OpenSourceSDRLab/XC7Z100-ADRV9371/hardware/XC7Z100-ADRV9371_Schematic.pdf

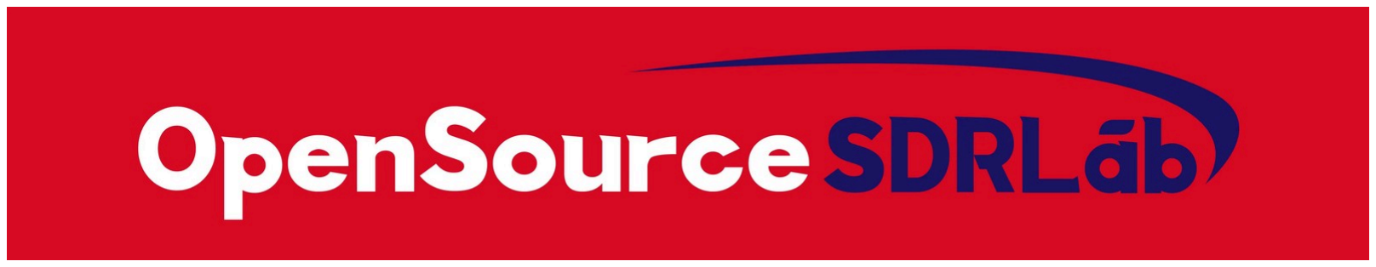
[picture p9: figure]

## © 2026 OpenSourceSDRLab. All rights reserved. · www.opensourcesdrlab.com

# OPENSOURCESDRLAB DOCUMENTATION

# XC7Z100-ADRV9371 Schematic

Product | XC7Z100-ADRV9371
Document | OSSDRLAB-XC7Z100-ADRV9371-SCH
Version | 1.0
Date | 2026-11-12

This document contains the circuit schematic (revision V1.0) of the OpenSourceSDRLab XC7Z100-ADRV9371 board, exported from Altium Designer (A2/A3/A4 sheets). The twenty schematic sheets follow this cover page.

OpenSourceSDRLab | XC7Z100-ADRV9371 Schematic

## © 2026 OpenSourceSDRLab. All rights reserved. · www.opensourcesdrlab.com

Sheet | Content
1 | Power supply: 12 V DC input and fuse, MP8774 / MP2145 buck regulators (5 V, 3.3 V, 1.8 V, 1.35 V, 1.0 V), MGT supplies, LP5907 LDO, power-good signals
2 | Zynq PS core: PS clock and reset, configuration and JTAG, boot-mode switch, MIO assignments (QSPI, SD card, USB ULPI, Ethernet RGMII, UART0), status LEDs
3 | Zynq HR I/O banks (banks 9–13): ADRV9371 control and GPIO, GPS, extension LVDS pairs
4 | Zynq HP I/O banks (banks 33–35): PL DDR3 interface and system clock
5 | Zynq GTX transceiver bank 112: JESD204B SERDES lanes and reference clocks
6 | Zynq PS DDR bank: PS DDR3 interface
7 | Zynq power pins and decoupling
8 | PS DDR3 memory (MT41K256M16, 1 GB)
9 | PL DDR3 memory (MT41K256M16, 1 GB)
10 | Two W25Q256 QSPI flash devices, microSD card slot
11 | USB 2.0: USB3320 ULPI PHY and USB Type-C connector
12 | Gigabit Ethernet: RTL8211F RGMII PHY and RJ45 jack
13 | Debug port: FT2232H USB-JTAG and USB-UART bridge on the DEBUG Type-C connector
14 | RF receive inputs: RX1, RX2, ORX1, ORX2 baluns and connectors
15 | AD9371 RF pins, TX1 and TX2 baluns, external TX/RX LO inputs
16 | Clocking: AD9528 clock generator, 122.88 MHz VCXO, reference clock input, status LEDs, SPI level translation
17 | AD9371 GPIO, SPI control and JESD204B SERDES interface
18 | AD9371 power pins and decoupling
19 | AD9371 power module: ADP5054 quad regulator (1.3 V analog, 1.3 V digital, 1.8 V, 3.3 V), filtering, enables, clock supply
20 | Other interfaces: M24C02 EEPROM, MAX-M10S GPS module with MMCX antenna input, 60-pin extension connector (24 LVDS pairs)

Product page: https://opensourcesdrlab.com/products/opensourcesdrlab-high-performance-ad9371-board-for-fpga-sdr-with-silver-shell-1 (https://opensourcesdrlab.com/products/opensourcesdrlab-high-performance-ad9371-board-for-fpga-sdr-with-silver-shell-1)

# Questions about the hardware: support@opensourcesdrlab.com

# VIN_2 13 GND

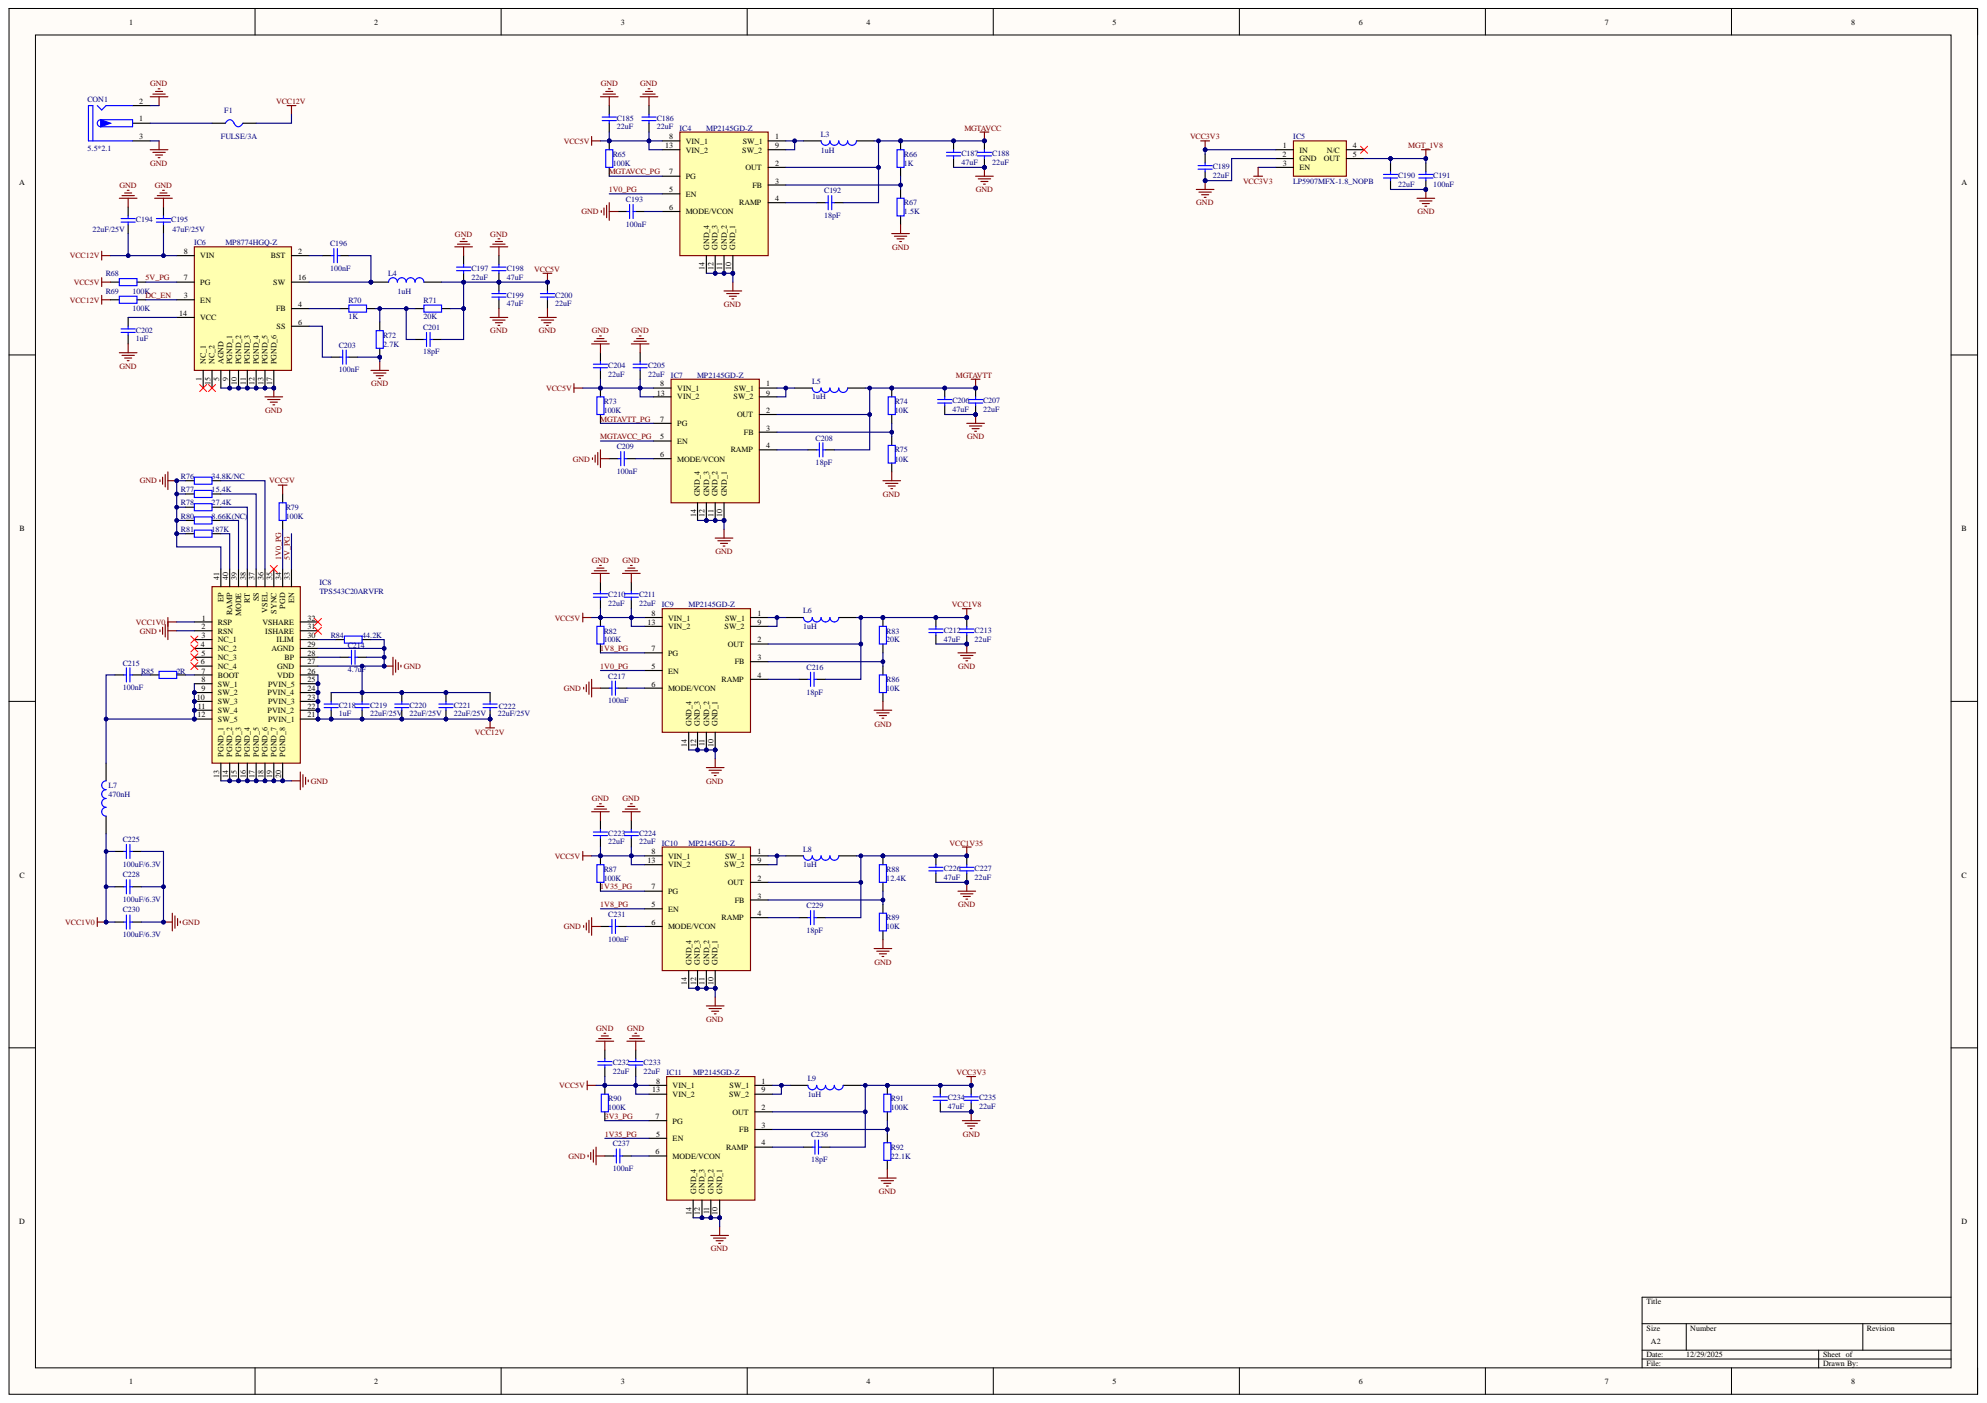
[picture p10: page 3]

# XC7Z100-2FFG900I U

4 PS_MIO0_500 | D23 PS_MIO1_500 | F23 PS_MIO2_500 | C23 PS_MIO3_500 | E23 PS_MIO4_500 | C24 PS_MIO5_500 | D24 PS_MIO6_500 | B24 PS_MIO7_500 | C21 PS_MIO8_500 | A24 PS_MIO9_500 | E22 PS_MIO10_500 | A23 PS_MIO11_500 | E21 PS_MIO12_500 | F22 PS_MIO13_500 | B22 PS_MIO14_500 | C22 PS_MIO15_500 | L19 PS_MIO16_501 | K21 PS_MIO17_501 | K20 PS_MIO18_501 | J20 PS_MIO19_501 | M20 PS_MIO20_501 | J19 PS_MIO21_501 | L20 PS_MIO22_501 | J21 PS_MIO23_501 | M19 PS_MIO24_501 | G19 PS_MIO25_501 | M17 PS_MIO26_501 | G20 PS_MIO27_501 | L17 PS_MIO28_501 | H22 PS_MIO29_501 | L18 PS_MIO30_501 | H21 PS_MIO31_501 | K17 PS_MIO32_501 | G22 PS_MIO33_501 | K18 PS_MIO34_501 | G21 PS_MIO35_501 | H17 PS_MIO36_501 | B21 PS_MIO37_501 | A20 PS_MIO38_501 | F18 PS_MIO39_501 | B20 PS_MIO40_501 | J18 PS_MIO41_501 | D20 PS_MIO42_501 | E18 PS_MIO43_501 | E20 PS_MIO44_501 | H18 PS_MIO45_501 | F20 PS_MIO46_501 | A18 PS_MIO47_501 | C19 PS_MIO48_501 | D18 PS_MIO49_501 | A19 PS_MIO50_501 | F19 PS_MIO51_501 | D19 PS_MIO52_501 | C18 PS_MIO53_501

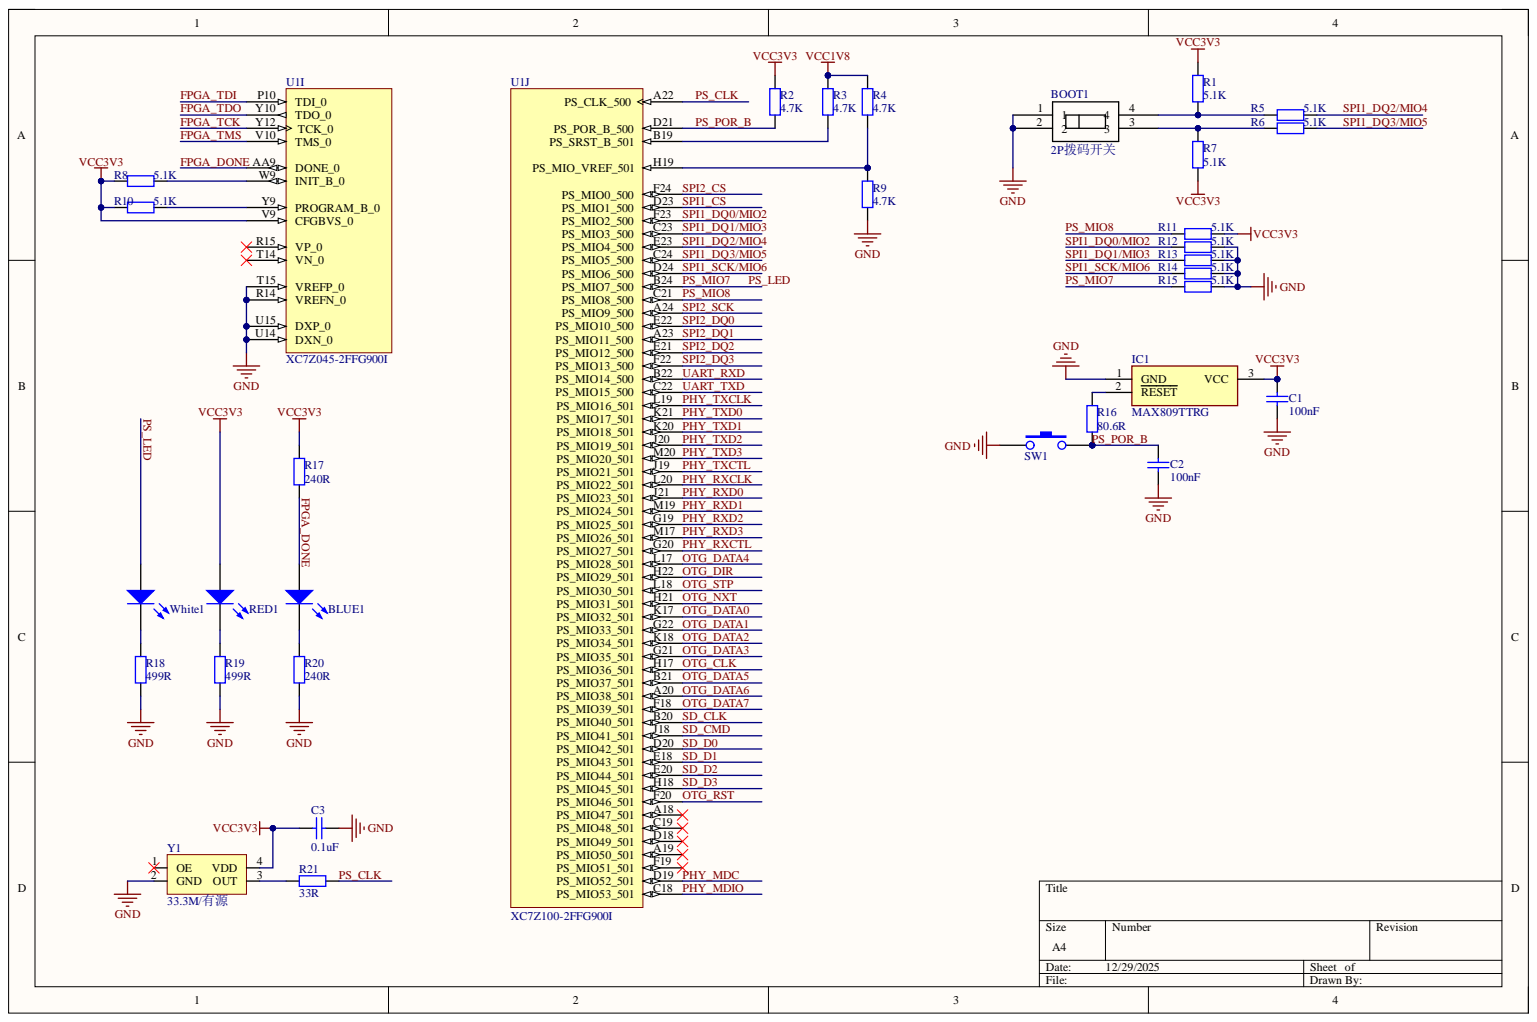
[picture p11: page 4]

1 IO_0_13 | P30 IO_L1P_T0_13 | R30 IO_L1N_T0_13 | T30 IO_L2P_T0_13 | U30 IO_L2N_T0_13 | N28 IO_L3P_T0_DQS_13 | P28 IO_L3N_T0_DQS_13 | N29 IO_L4P_T0_13 | P29 IO_L4N_T0_13 | T29 IO_L5P_T0_13 | U29 IO_L5N_T0_13 | R28 IO_L6P_T0_13 | T28 IO_L6N_T0_VREF_13 | V28 IO_L7P_T1_13 | V29 IO_L7N_T1_13 | W29 IO_L8P_T1_13 | W30 IO_L8N_T1_13 | V27 IO_L9P_T1_DQS_13 | W28 IO_L9N_T1_DQS_13 | W25 IO_L10P_T1_13 | W26 IO_L10N_T1_13 | U25 IO_L11P_T1_SRCC_13 | V26 IO_L11N_T1_SRCC_13 | U26 IO_L12P_T1_MRCC_13 | U27 IO_L12N_T1_MRCC_13 | R25 IO_L13P_T2_MRCC_13 | R26 IO_L13N_T2_MRCC_13 | R27 IO_L14P_T2_SRCC_13 | T27 IO_L14N_T2_SRCC_13 | N26 IO_L15P_T2_DQS_13 | N27 IO_L15N_T2_DQS_13 | P25 IO_L16P_T2_13 | P26 IO_L16N_T2_13 | T24 IO_L17P_T2_13 | T25 IO_L17N_T2_13 | P23 IO_L18P_T2_13 | P24 IO_L18N_T2_13 | P21 IO_L19P_T3_13 | R21 IO_L19N_T3_VREF_13 | T22 IO_L20P_T3_13 | T23 IO_L20N_T3_13 | R22 IO_L21P_T3_DQS_13 | R23 IO_L21N_T3_DQS_13 | U22 IO_L22P_T3_13 | V22 IO_L22N_T3_13 | U24 IO_L23P_T3_13 | V24 IO_L23N_T3_13 | V23 IO_L24P_T3_13 | W24 IO_L24N_T3_13 | V21 IO_25_13
0 IO_L1N_T0_12 | AB29 IO_L2P_T0_12 | AB30 IO_L2N_T0_12 | Y26 IO_L3P_T0_DQS_12 | Y27 IO_L3N_T0_DQS_12 | Y28 IO_L4P_T0_12 | AA29 IO_L4N_T0_12 | AA27 IO_L5P_T0_12 | AA28 IO_L5N_T0_12 | AB25 IO_L6P_T0_12 | AB26 IO_L6N_T0_VREF_12 | AC26 IO_L7P_T1_12 | AD26 IO_L7N_T1_12 | AD30 IO_L8P_T1_12 | AE30 IO_L8N_T1_12 | AC29 IO_L9P_T1_DQS_12 | AD29 IO_L9N_T1_DQS_12 | AD25 IO_L10P_T1_12 | AE26 IO_L10N_T1_12 | AB27 IO_L11P_T1_SRCC_12 | AC27 IO_L11N_T1_SRCC_12 | AC28 IO_L12P_T1_MRCC_12 | AD28 IO_L12N_T1_MRCC_12 | AE28 IO_L13P_T2_MRCC_12 | AF28 IO_L13N_T2_MRCC_12 | AE27 IO_L14P_T2_SRCC_12 | AF27 IO_L14N_T2_SRCC_12 | AF29 IO_L15P_T2_DQS_12 | AG29 IO_L15N_T2_DQS_12 | AF30 IO_L16P_T2_12 | AG30 IO_L16N_T2_12 | AG26 IO_L17P_T2_12 | AG27 IO_L17N_T2_12 | AE25 IO_L18P_T2_12 | AF25 IO_L18N_T2_12 | AH28 IO_L19P_T3_12 | AH29 IO_L19N_T3_VREF_12 | AJ30 IO_L20P_T3_12 | AK30 IO_L20N_T3_12 | AJ28 IO_L21P_T3_DQS_12 | AJ29 IO_L21N_T3_DQS_12 | AK27 IO_L22P_T3_12 | AK28 IO_L22N_T3_12 | AH26 IO_L23P_T3_12 | AH27 IO_L23N_T3_12 | AJ26 IO_L24P_T3_12 | AK26 IO_L24N_T3_12 | AA25 IO_25_12

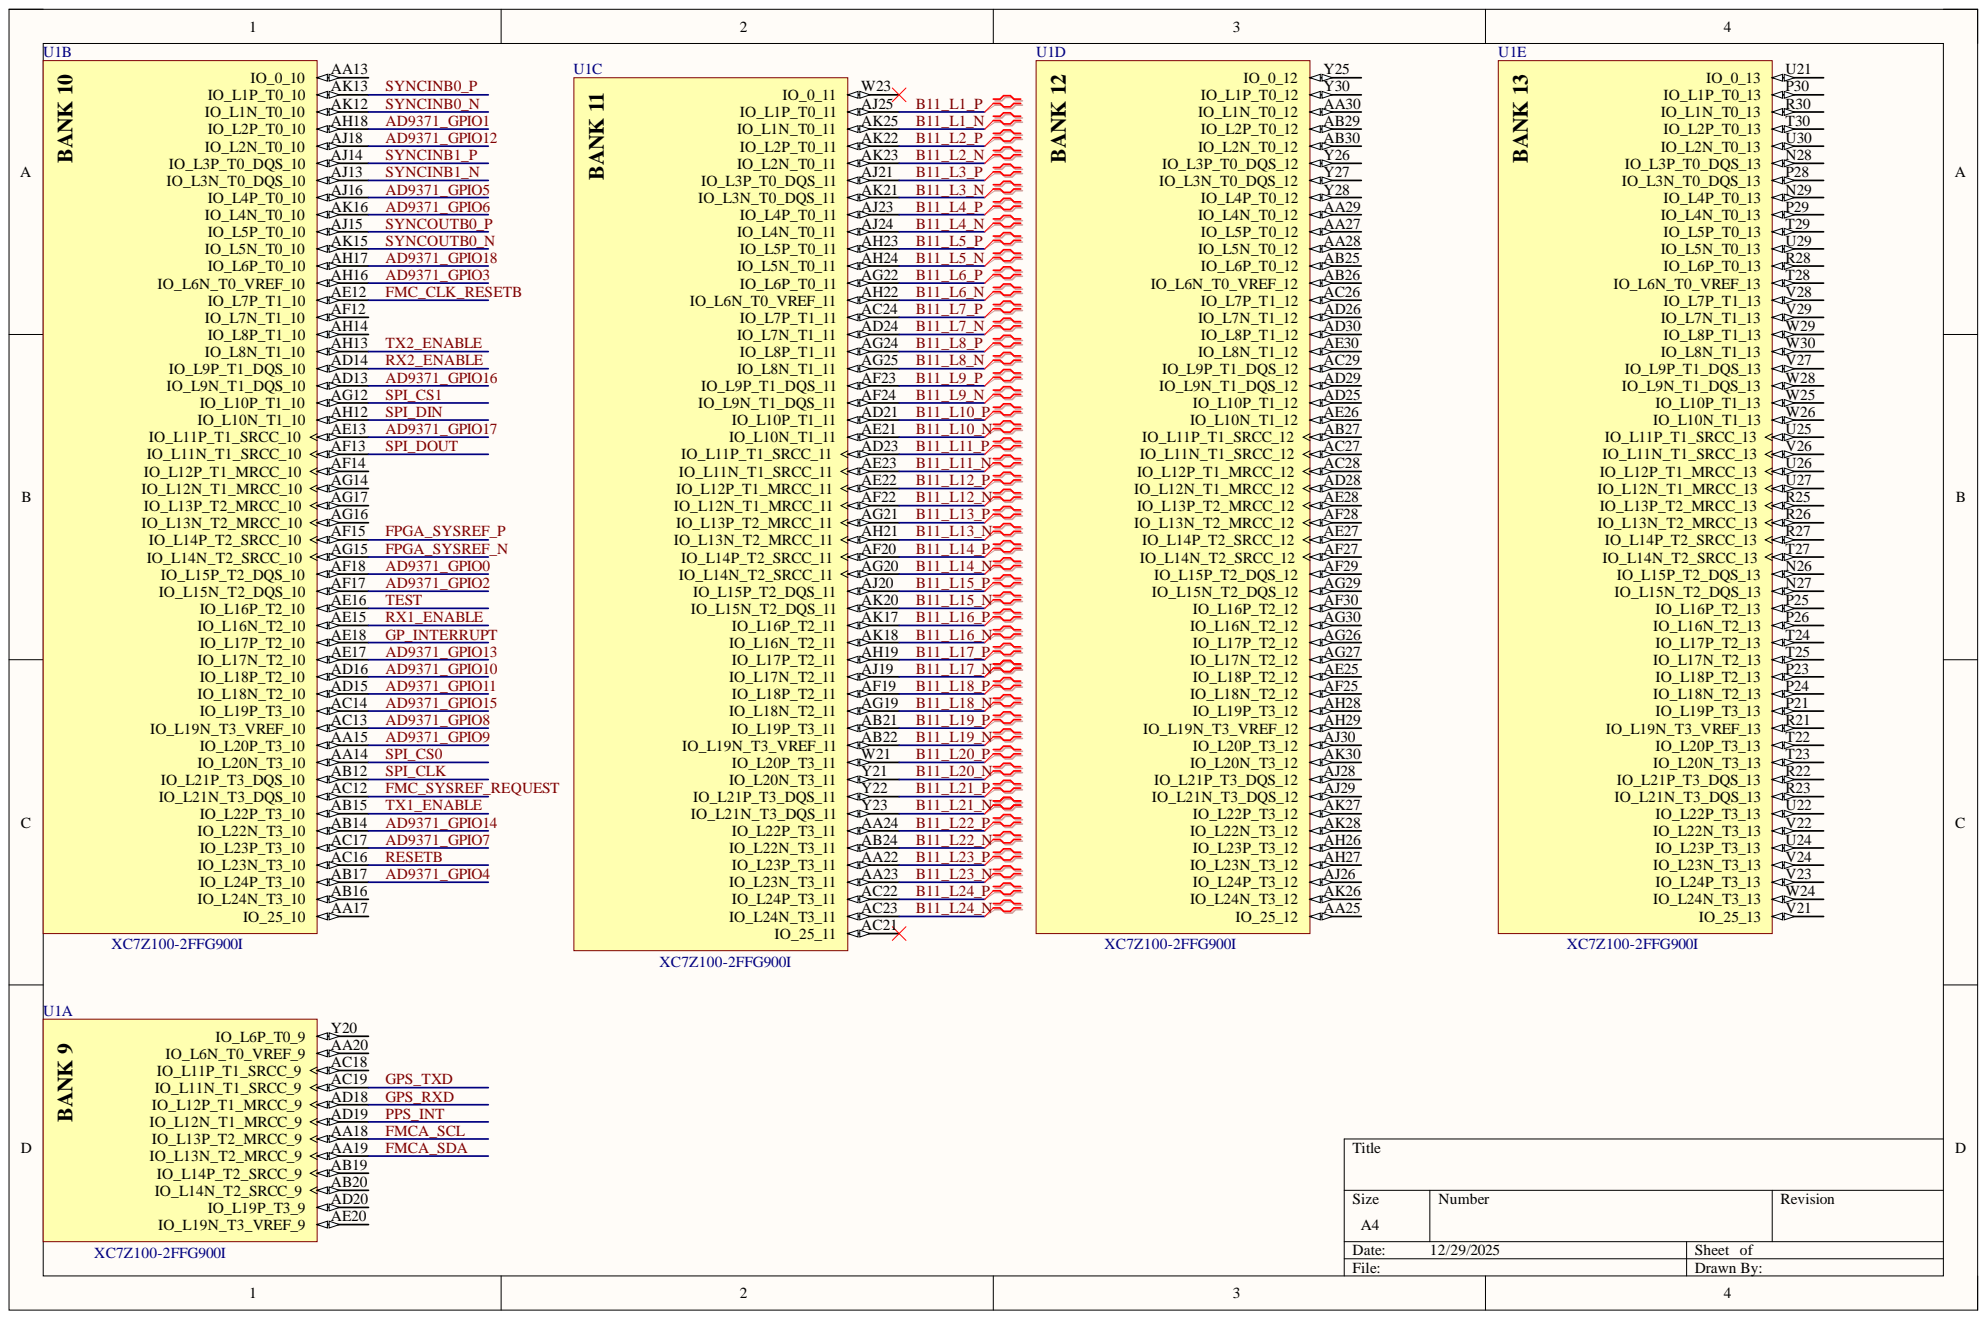
[picture p12: page 5]
SPI_CL; K FMC_SYSREF_RE; SPI_; FMC_CL; _RESE; SPI_CS1; SPI_CS0 AD9371_; RESE; ERRU; FMCA; _SCL; FPG; _SYSREF_; NCO; NCINB1; NCINB0; PPS_IN; GPS_RX; GPS_; XC7Z100-2FFG900I; 9 KNAB; 0 IO_L6N_T0_VREF_9; AC18 IO_L11P_T1_SRCC_9; AC19 IO_L11N_T1_SRCC_9; AD18 IO_L12P_T1_MRCC_9; AD19 IO_L12N_T1_MRCC_9; AA18 IO_L13P_T2_MRCC_9; AA19 IO_L13N_T2_MRCC_9; AB19 IO_L14P_T2_SRCC_9; AB20 IO_L14N_T2_SRCC_9; AE20 IO_L19N_T3_VREF_9; 31 KNAB; 21 KNAB; 11 KNAB; AJ21 IO_L3P_T0_DQS_11; AK21 IO_L3N_T0_DQS_11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

D R24 | 1K | GND R26 | 80.6R | VCC1V
6 IO_0_VRN_35 | L15 IO_L1P_T0_AD0P_35 | L14 IO_L1N_T0_AD0N_35 | J13 IO_L2P_T0_AD8P_35 | H13 IO_L2N_T0_AD8N_35 | L13 IO_L3P_T0_DQS_AD1P_35 | K13 IO_L3N_T0_DQS_AD1N_35 | J14 IO_L4P_T0_35 | H14 IO_L4N_T0_35 | K15 IO_L5P_T0_AD9P_35 | J15 IO_L5N_T0_AD9N_35 | J16 IO_L6P_T0_35 | H16 IO_L6N_T0_VREF_35 | G17 IO_L7P_T1_AD2P_35 | G16 IO_L7N_T1_AD2N_35 | G15 IO_L8P_T1_AD10P_35 | G14 IO_L8N_T1_AD10N_35 | G12 IO_L9P_T1_DQS_AD3P_35 | F12 IO_L9N_T1_DQS_AD3N_35 | F13 IO_L10P_T1_AD11P_35 | E12 IO_L10N_T1_AD11N_35 | E13 IO_L11P_T1_SRCC_35 | D13 IO_L11N_T1_SRCC_35 | F15 IO_L12P_T1_MRCC_35 | F14 IO_L12N_T1_MRCC_35 | E16 IO_L13P_T2_MRCC_35 | E15 IO_L13N_T2_MRCC_35 | D15 IO_L14P_T2_AD4P_SRCC_35 | D14 IO_L14N_T2_AD4N_SRCC_35 | F17 IO_L15P_T2_DQS_AD12P_35 | E17 IO_L15N_T2_DQS_AD12N_35 | D16 IO_L16P_T2_35 | C16 IO_L16N_T2_35 | C17 IO_L17P_T2_AD5P_35 | B16 IO_L17N_T2_AD5N_35 | B17 IO_L18P_T2_AD13P_35 | A17 IO_L18N_T2_AD13N_35 | C14 IO_L19P_T3_35 | C13 IO_L19N_T3_VREF_35 | C12 IO_L20P_T3_AD6P_35 | B12 IO_L20N_T3_AD6N_35 | B15 IO_L21P_T3_DQS_AD14P_35 | A15 IO_L21N_T3_DQS_AD14N_35 | C11 IO_L22P_T3_AD7P_35 | B11 IO_L22N_T3_AD7N_35 | B14 IO_L23P_T3_35 | A14 IO_L23N_T3_35 | A13 IO_L24P_T3_AD15P_35 | A12 IO_L24N_T3_AD15N_35 | M16 IO_25_VRP_35

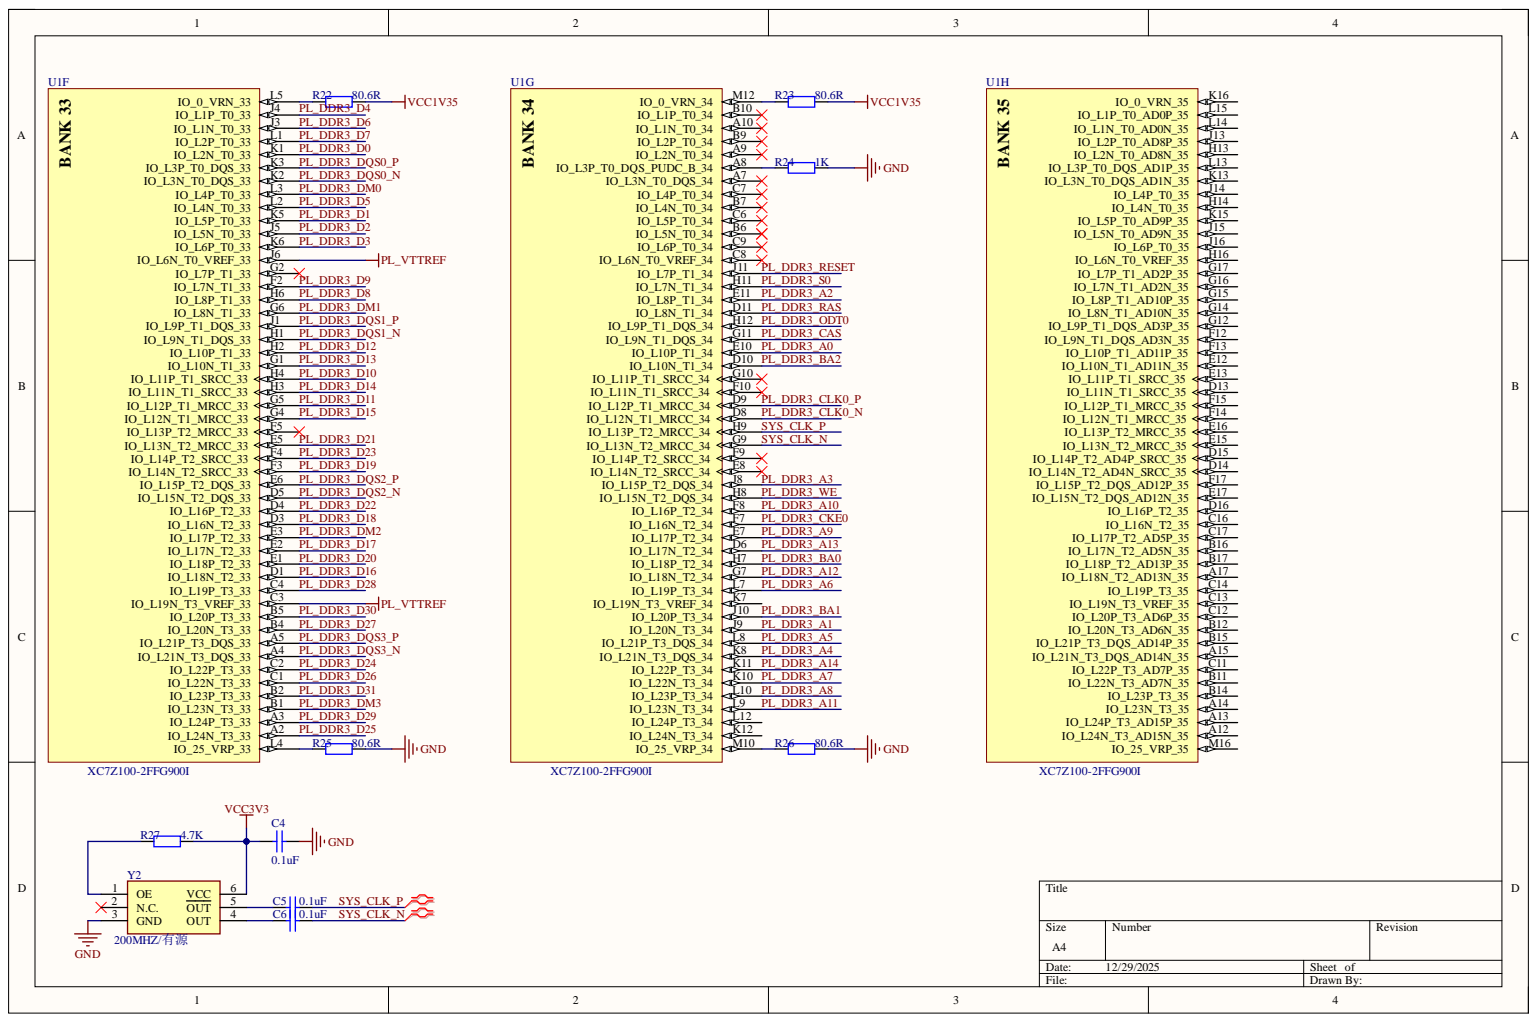
[picture p13: page 6]

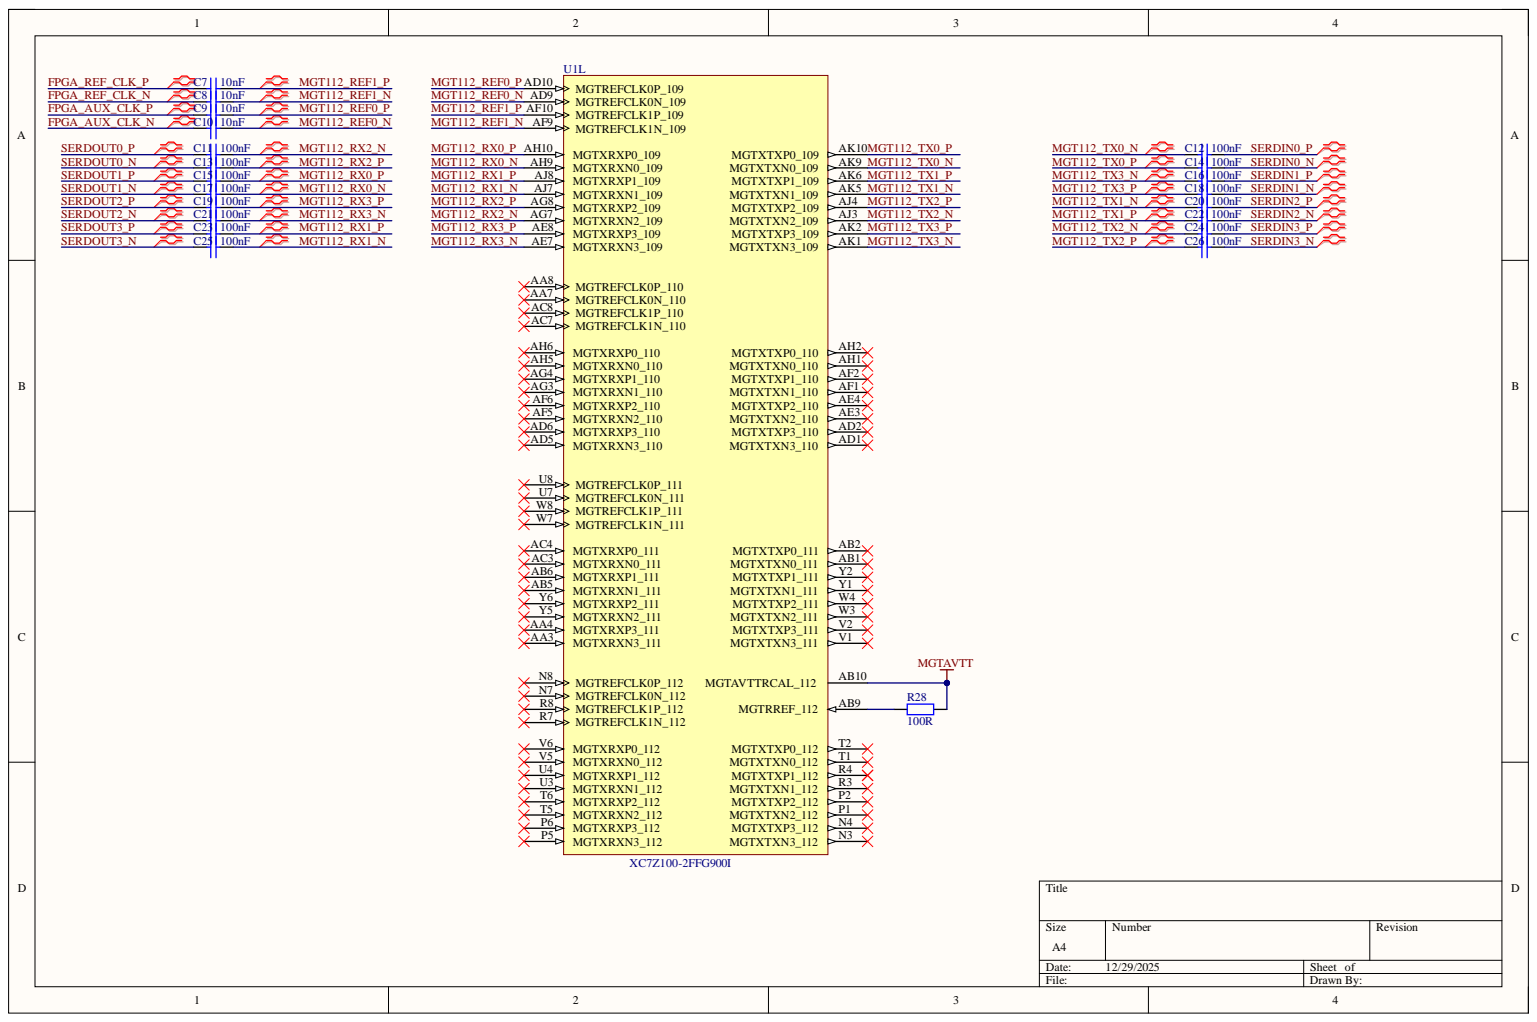
[picture p14: page 7]

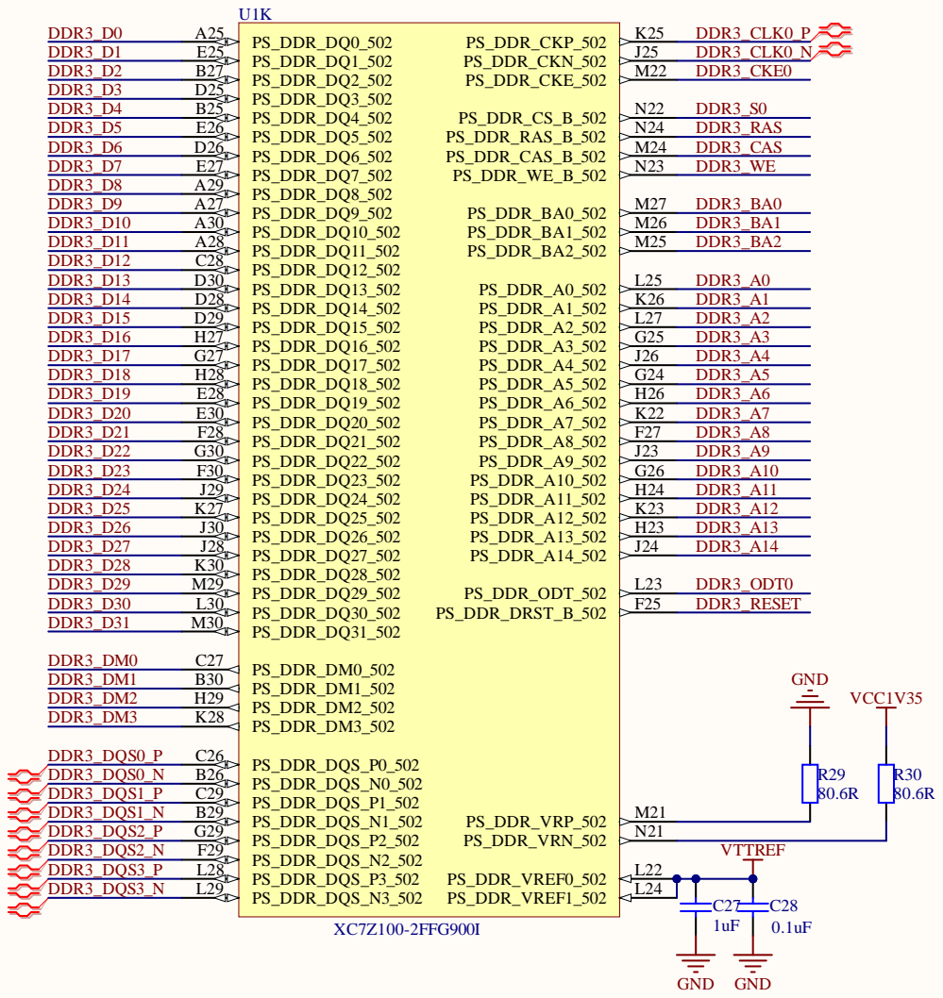
[picture p15: page 8]

M13 | VCCINT M15 | VCCINT N12 | VCCINT N14 | VCCINT P13 | VCCINT R12 | VCCINT R16 | VCCINT T13 | VCCINT U12 | VCCINT U16 | VCCINT V13 | VCCINT V15 | VCCINT W12 | VCCINT W14 | VCCINT W16 | VCCINT Y17 | VCCINT

### PIC2902 COC29

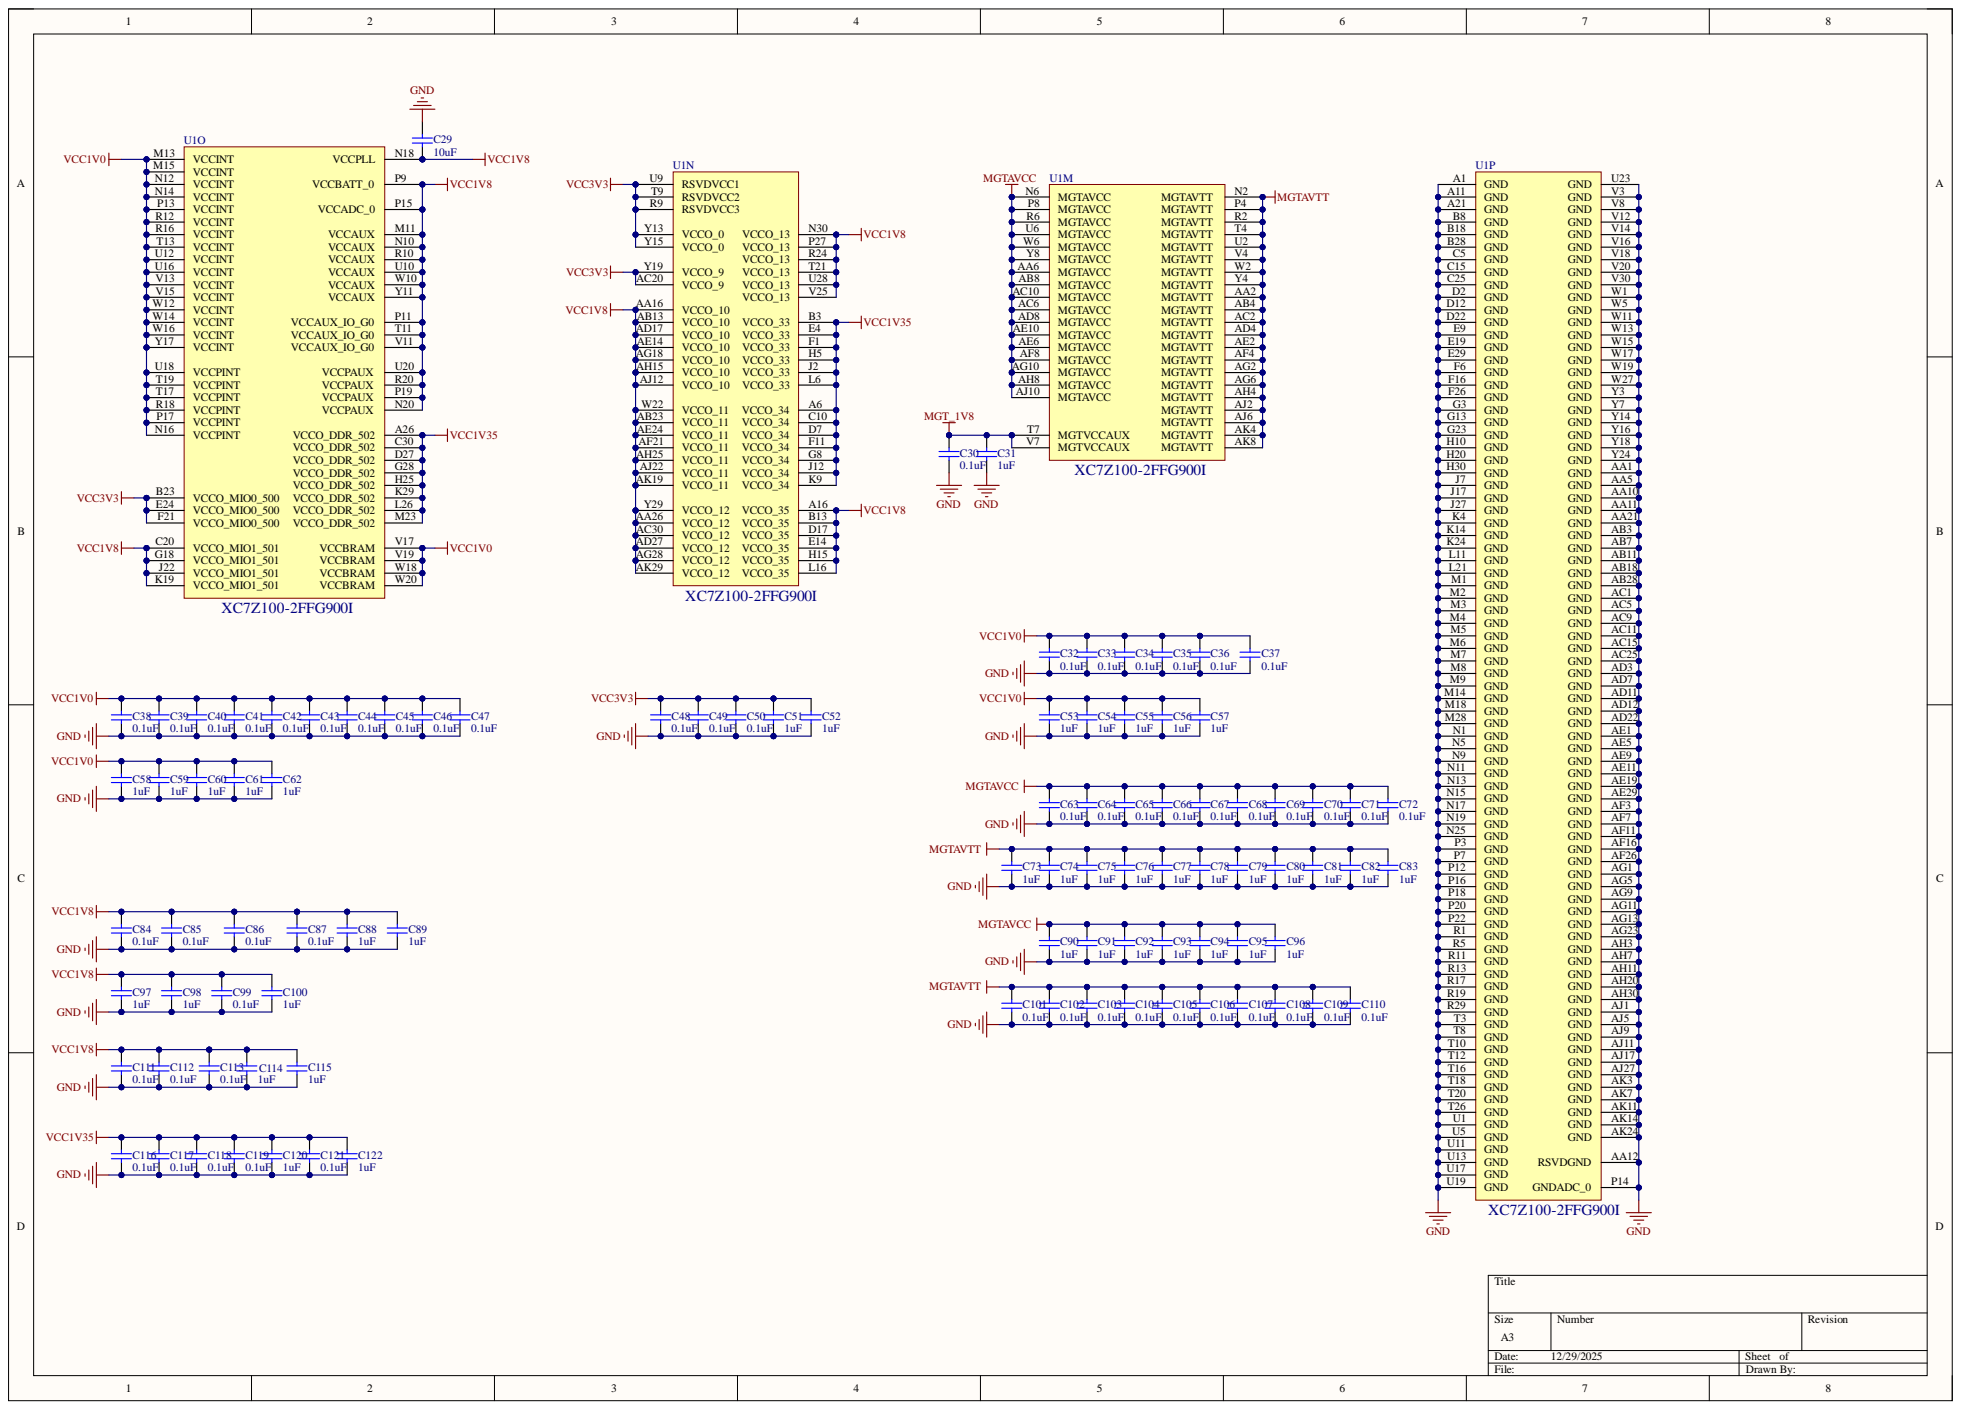
[picture p16: page 9]

PIC8602 COC86

PIC9502 COC95

5 P2 | A2 P3 | A1 P7 | A4 P8 | A7 R2 | A9 R3 | A1

# U2A MT41K256M16R

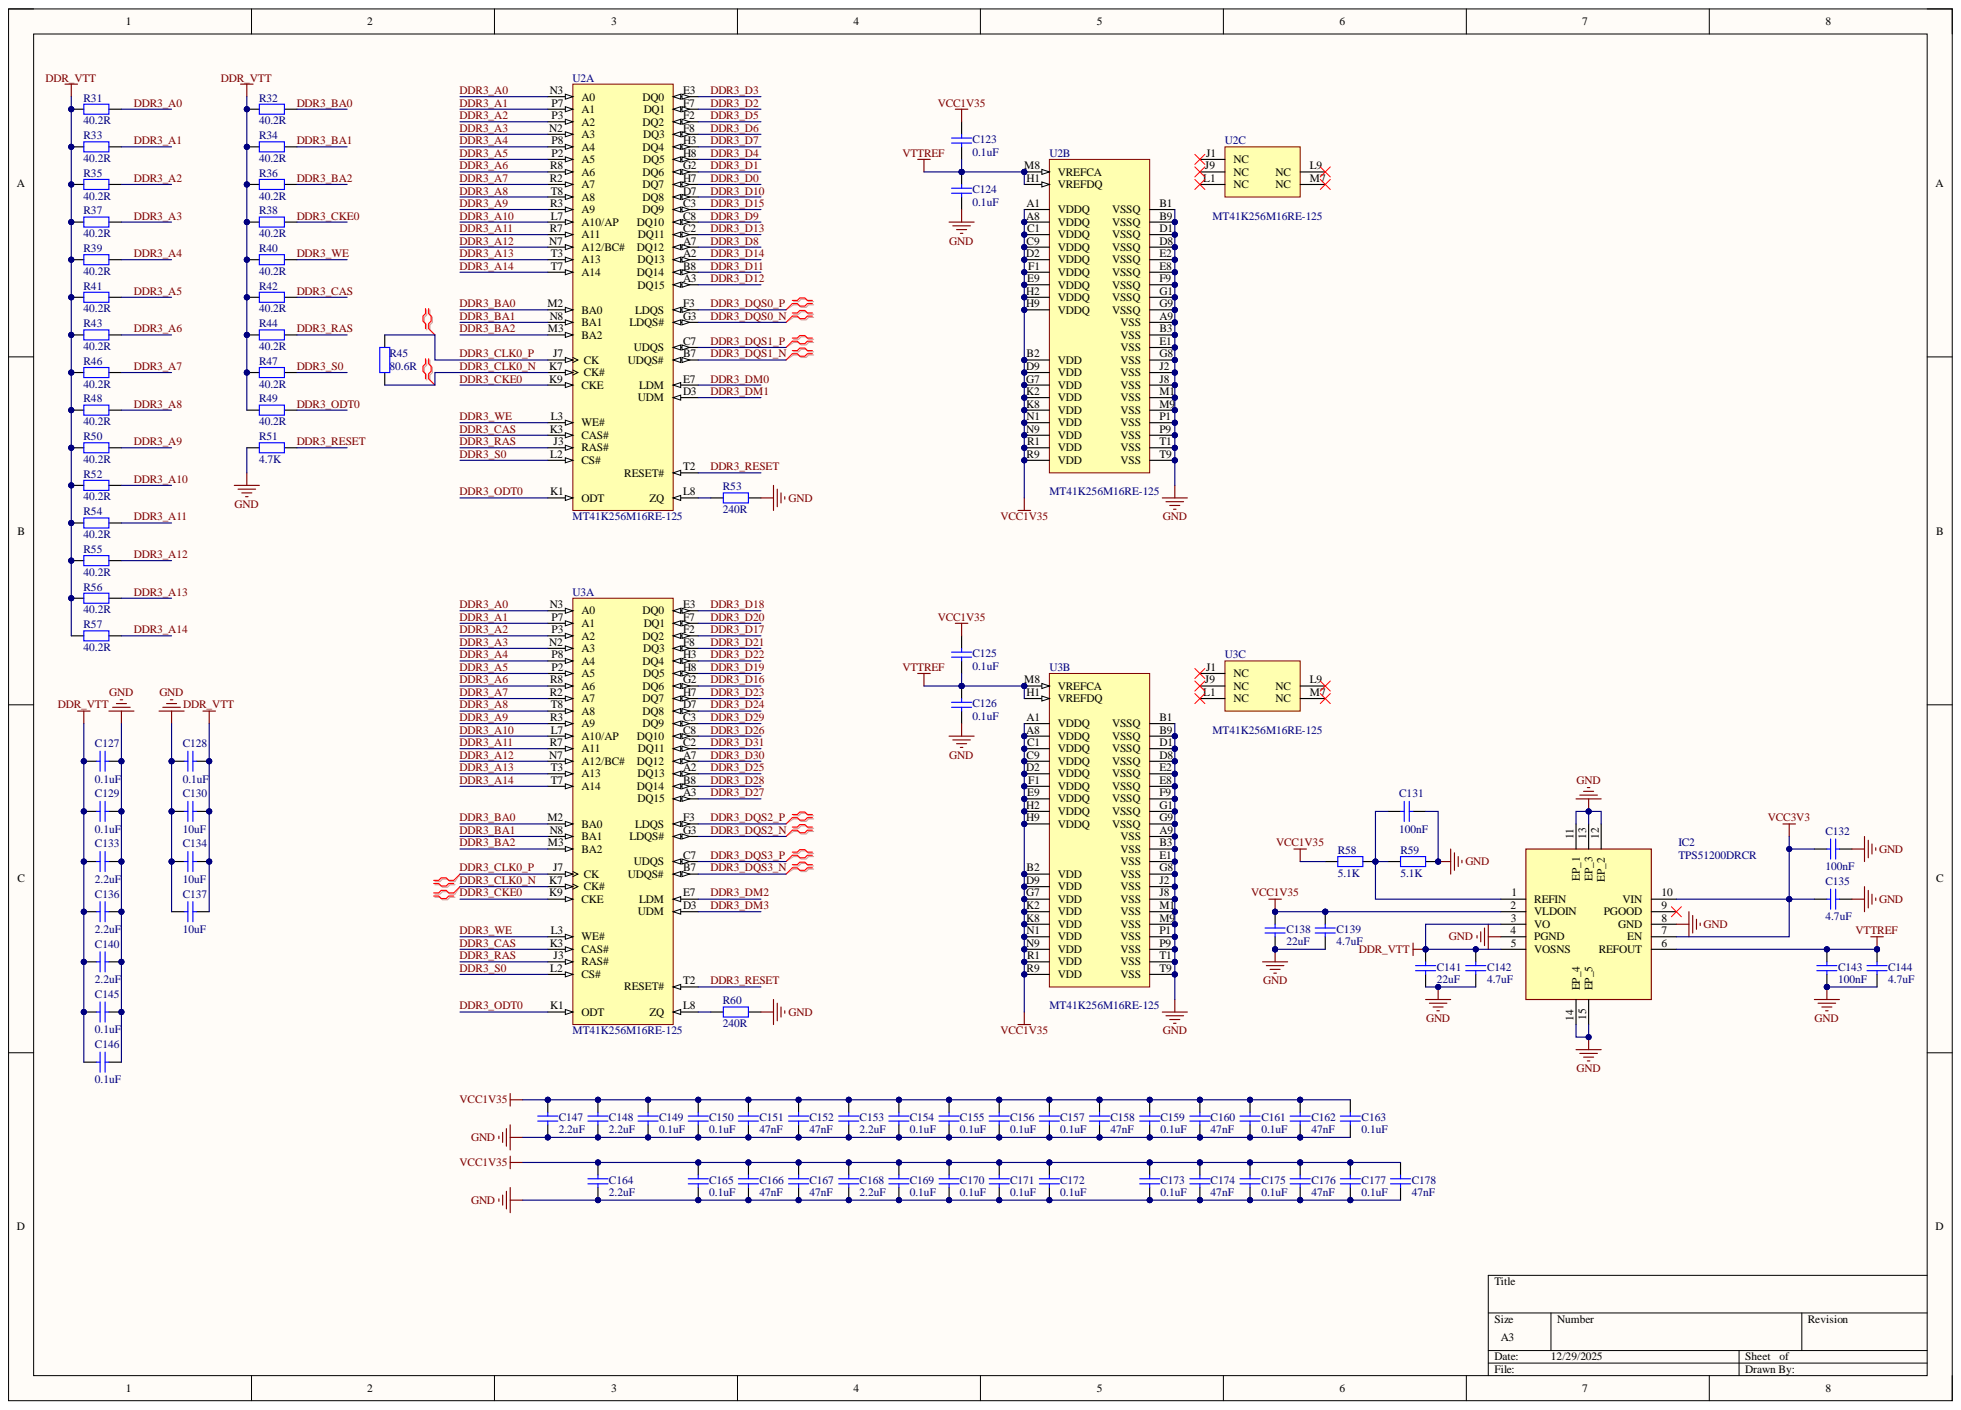
[picture p17: page 10]

5 P2 | A2 P3 | A1 P7 | A4 P8 | A7 R2 | A9 R3 | A1

# U8A MT41K256M16R

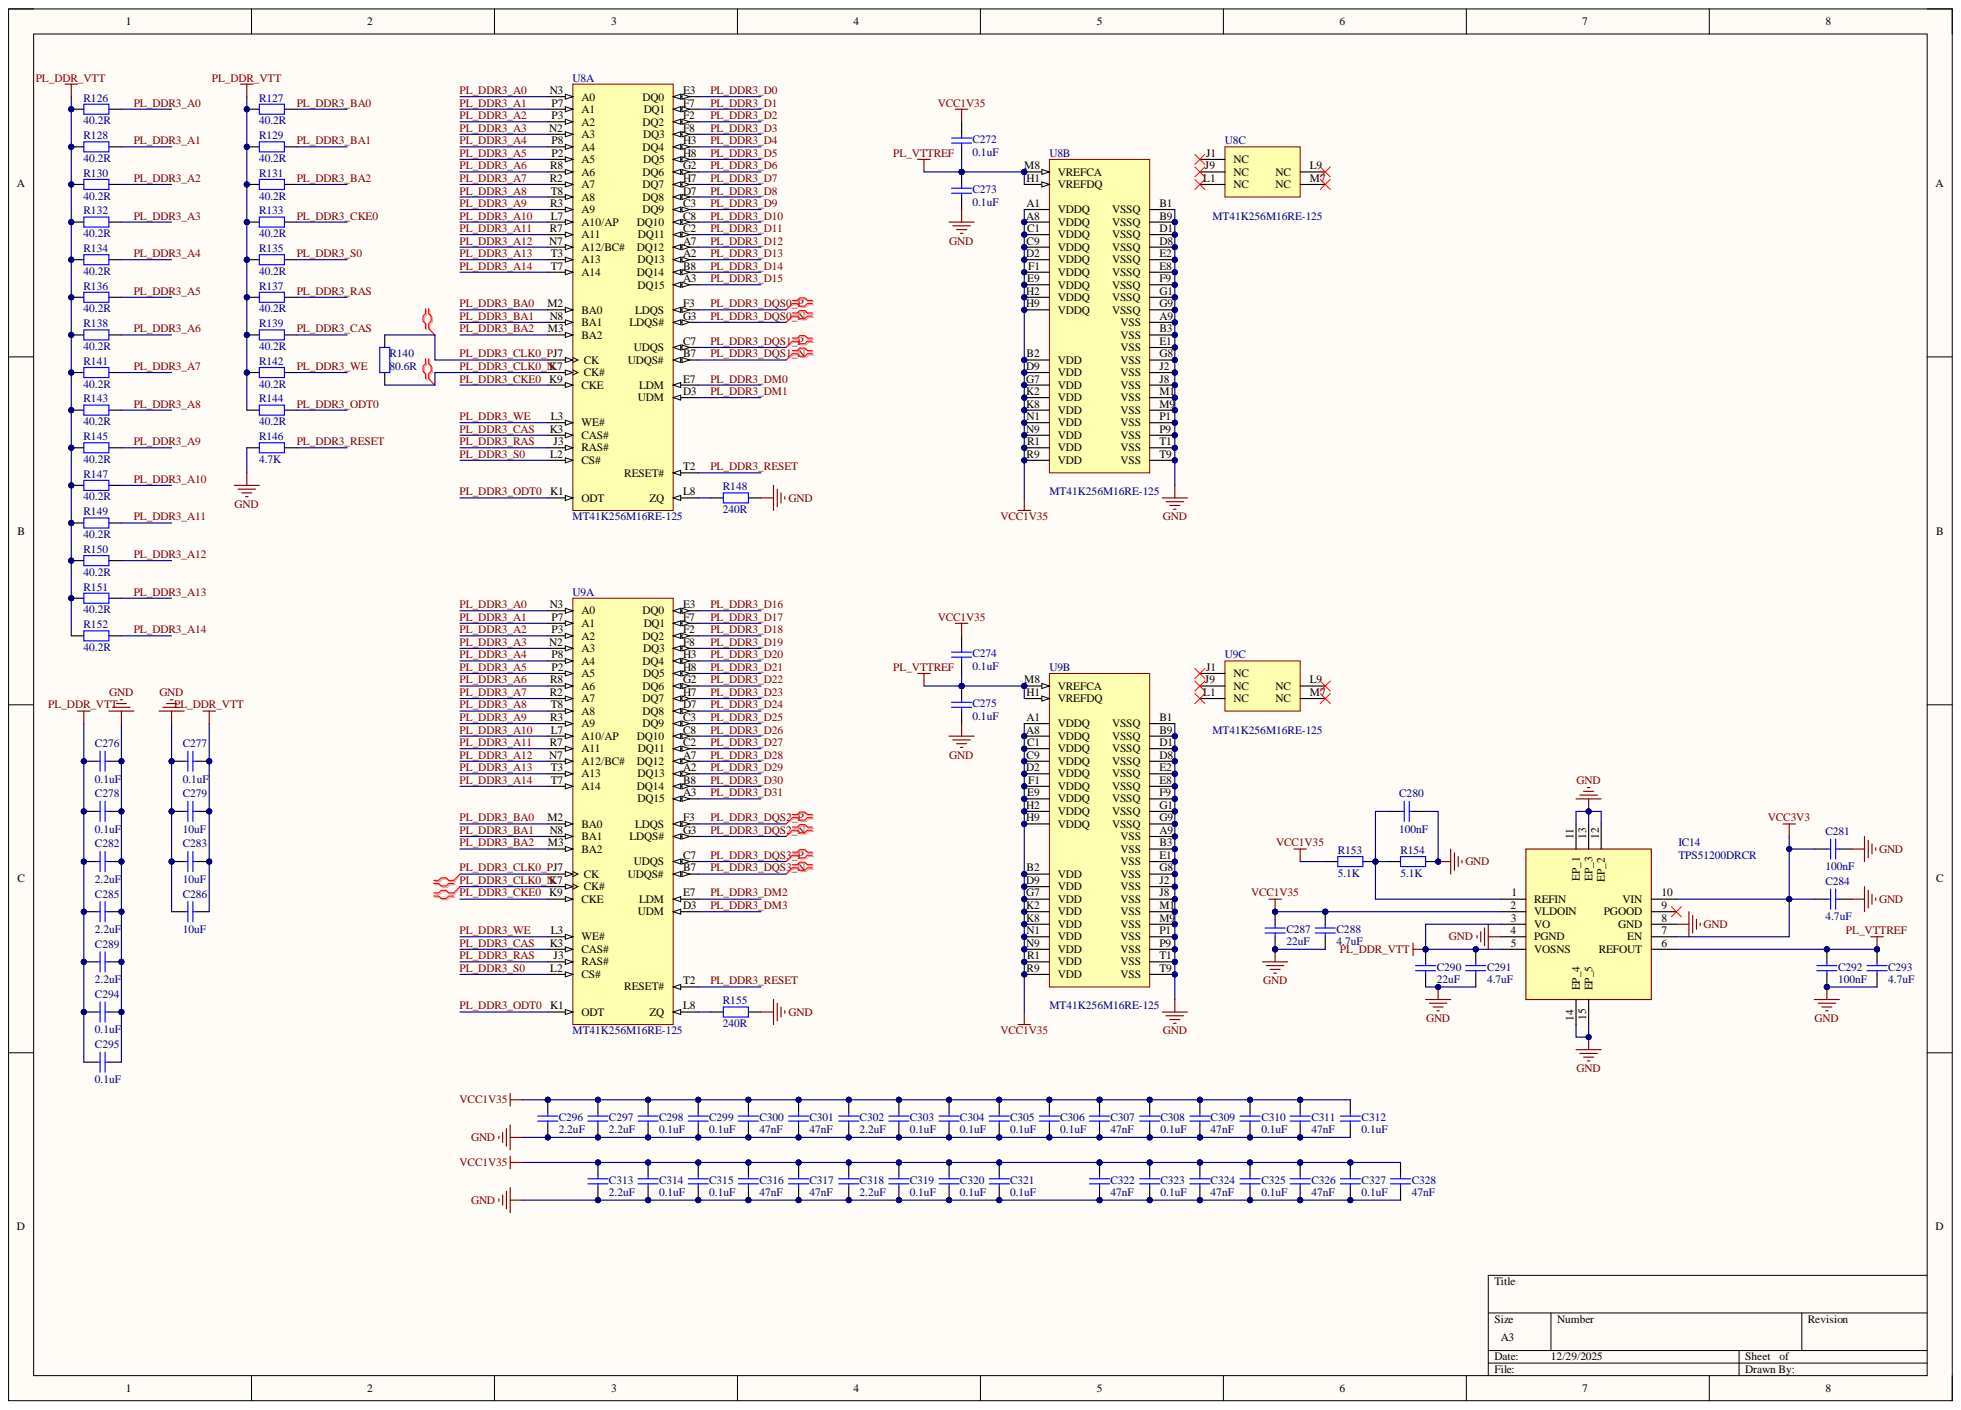
[picture p18: page 11]

# 3VCC1

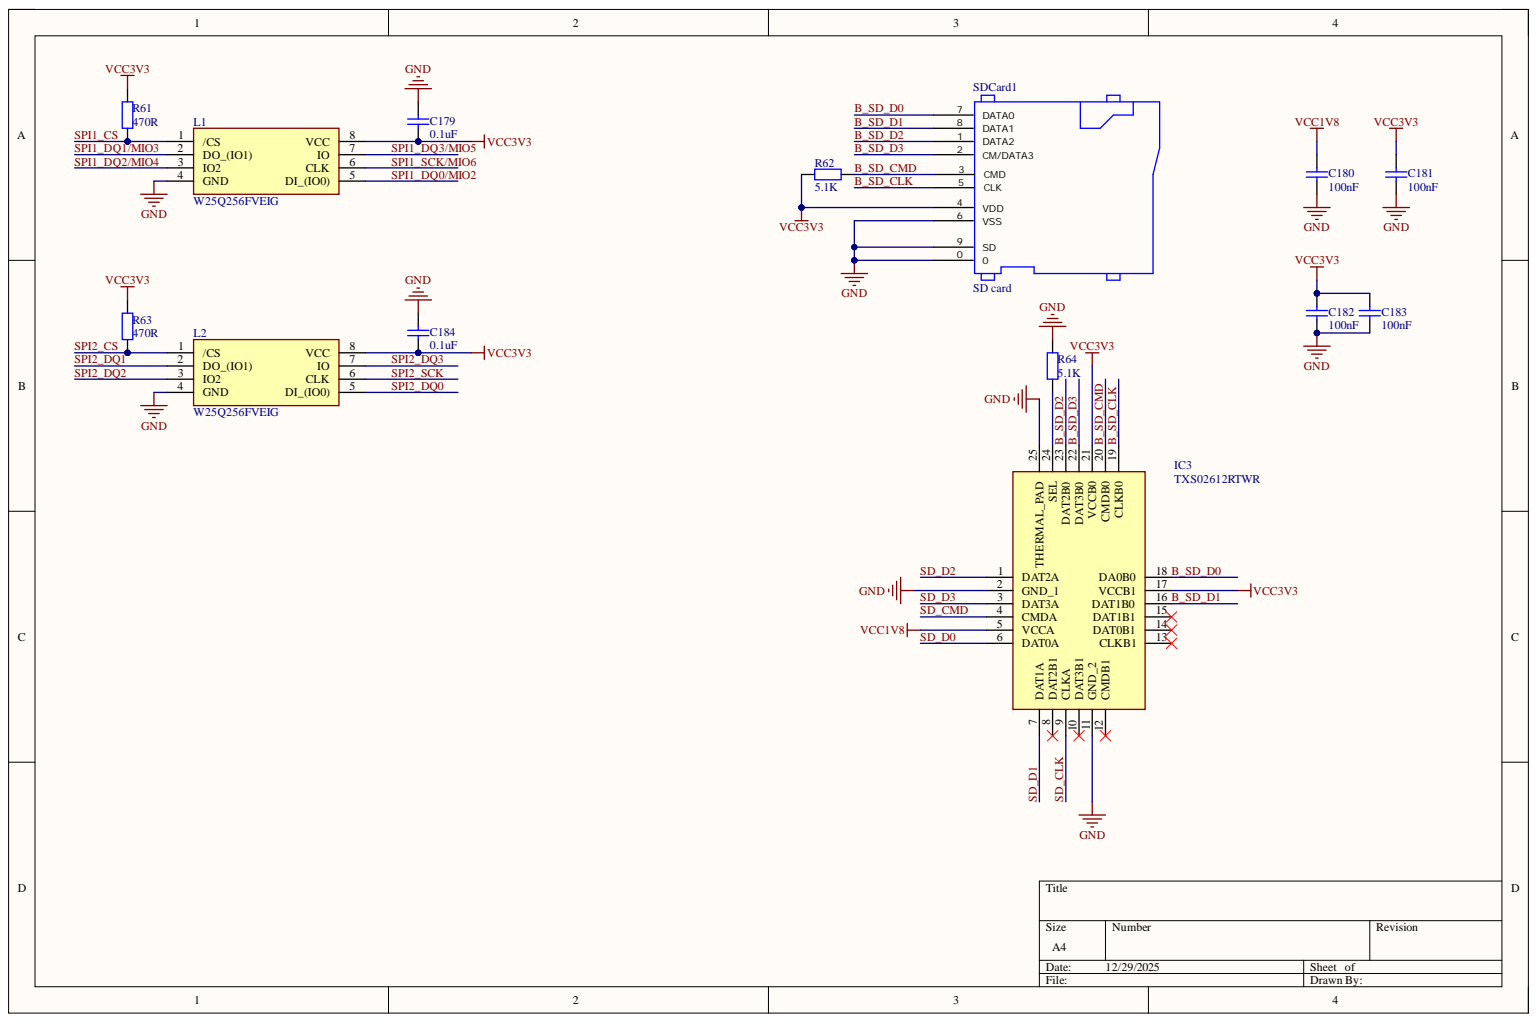
[picture p19: page 12]
Size; umb; Rev; Draw; VCC3; SPI1; _SCK/MI; SPI2; VCC; VDD; VSS; SDCard; SD card; CMD; DAT1A 7; DAT2B1 8 CLKA 9; DAT3B1 10; GND; CMDB1 12 DA; VCCB; THERMAL; PAD 25; SEL 24; DAT2B0 23; DAT3B0 22; VCCB0 21; CMDB0 20; CLKB0 19; IC3 TXS0; CLK B; CLK; VCC1

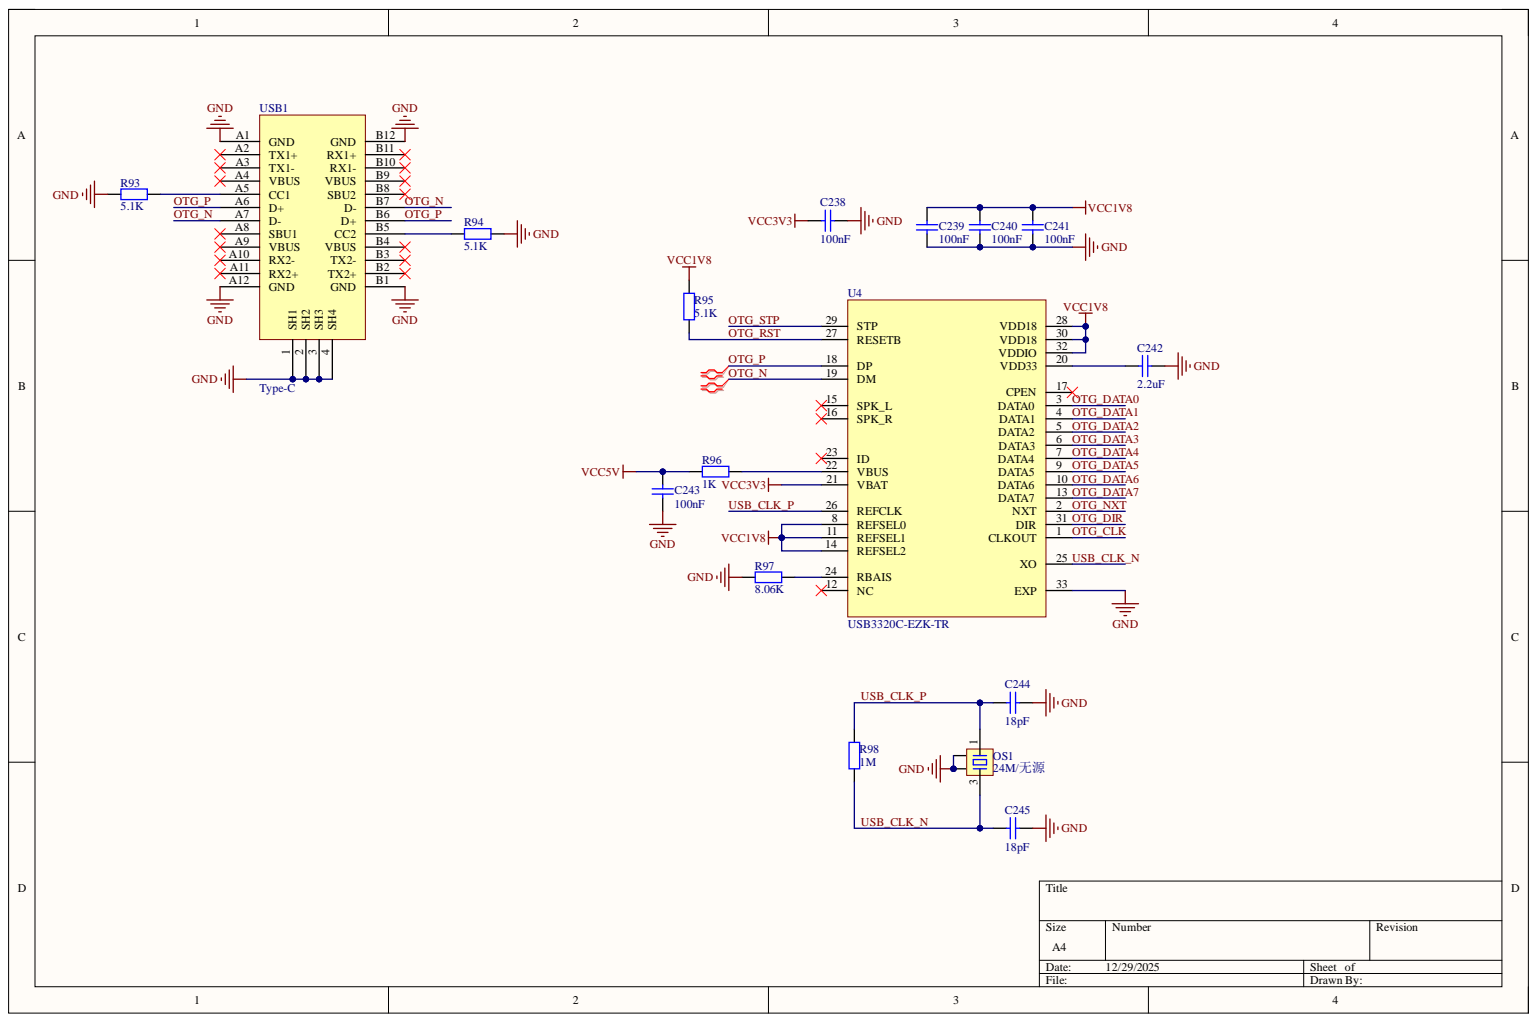
[picture p20: page 13]

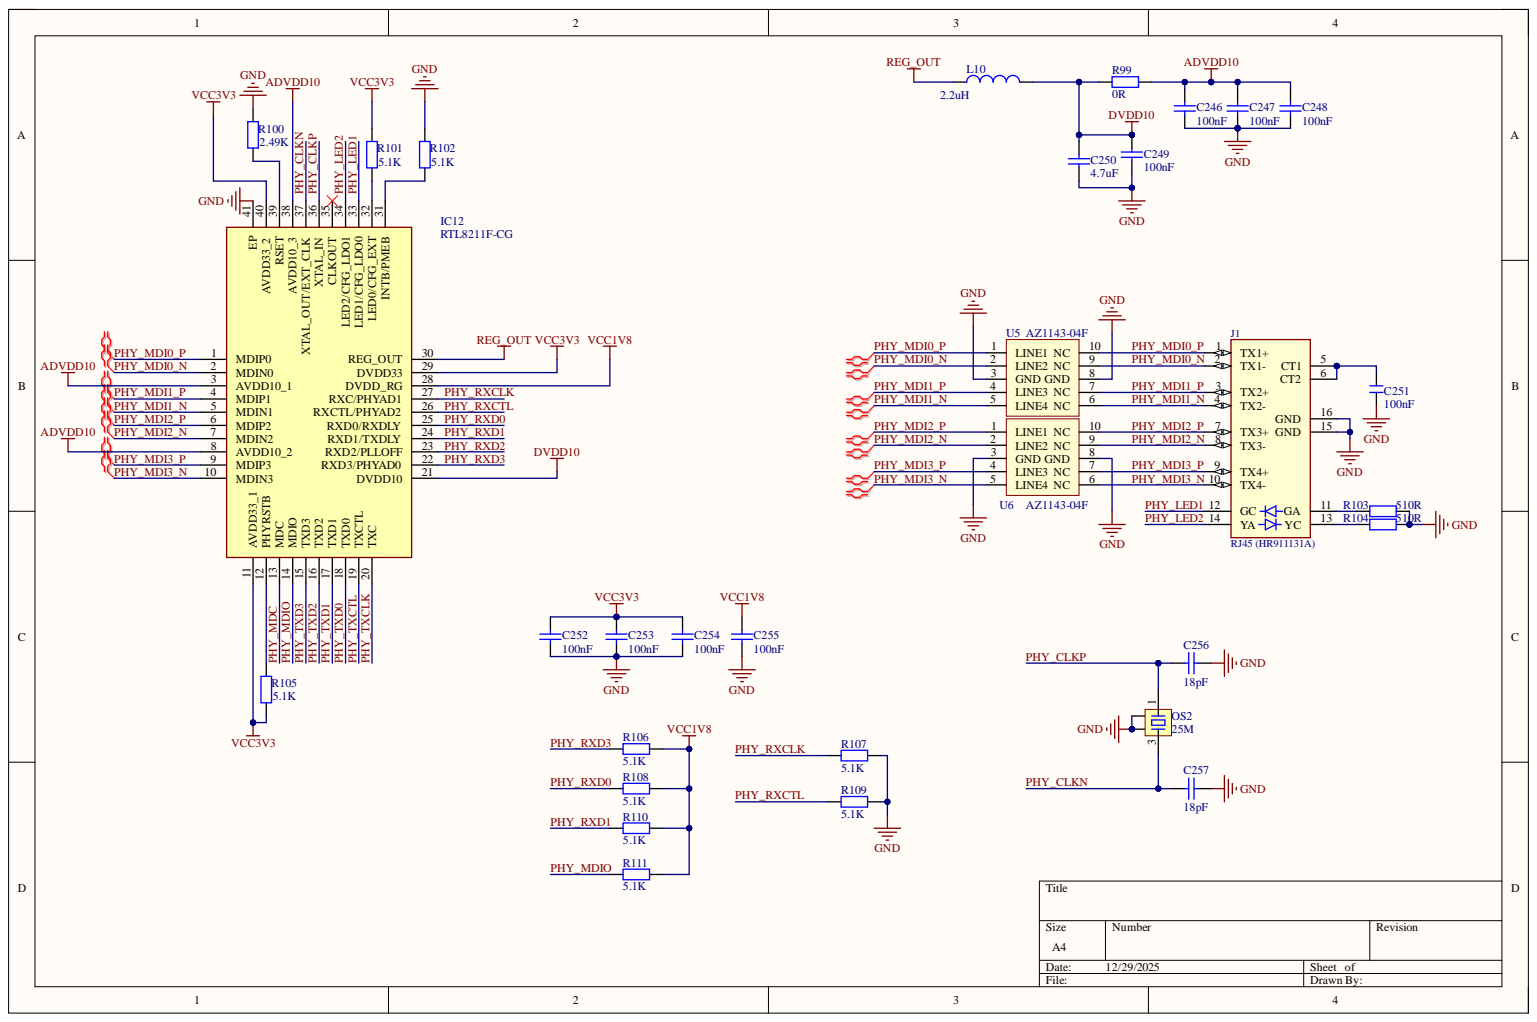
[picture p21: page 14]

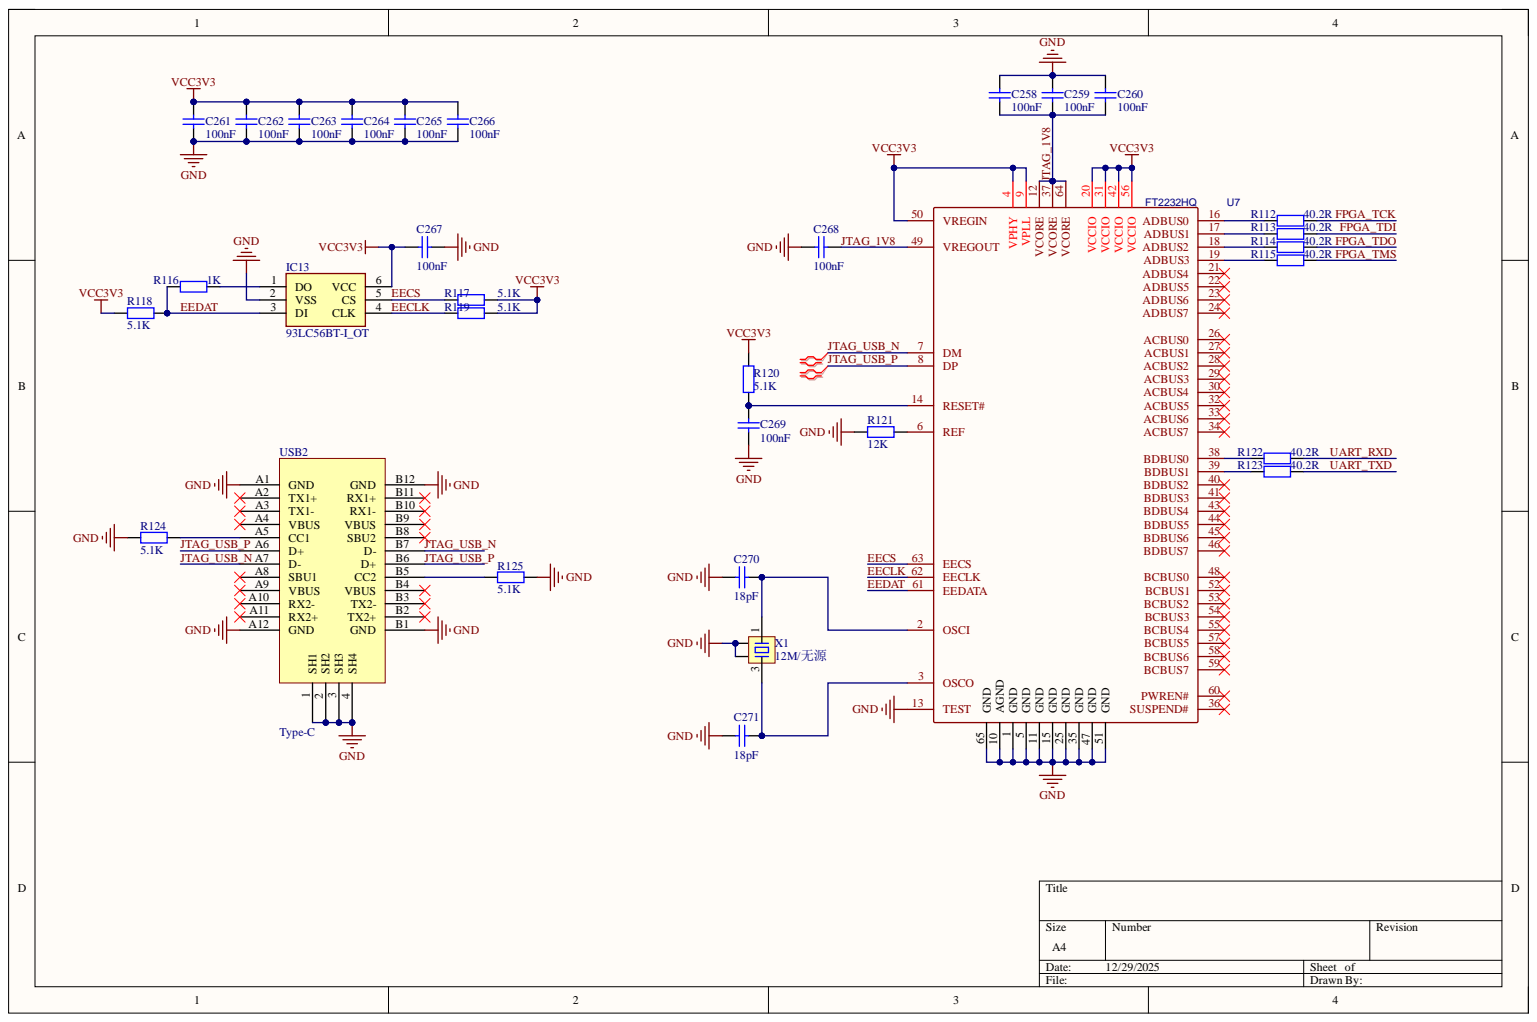
[picture p22: page 15]

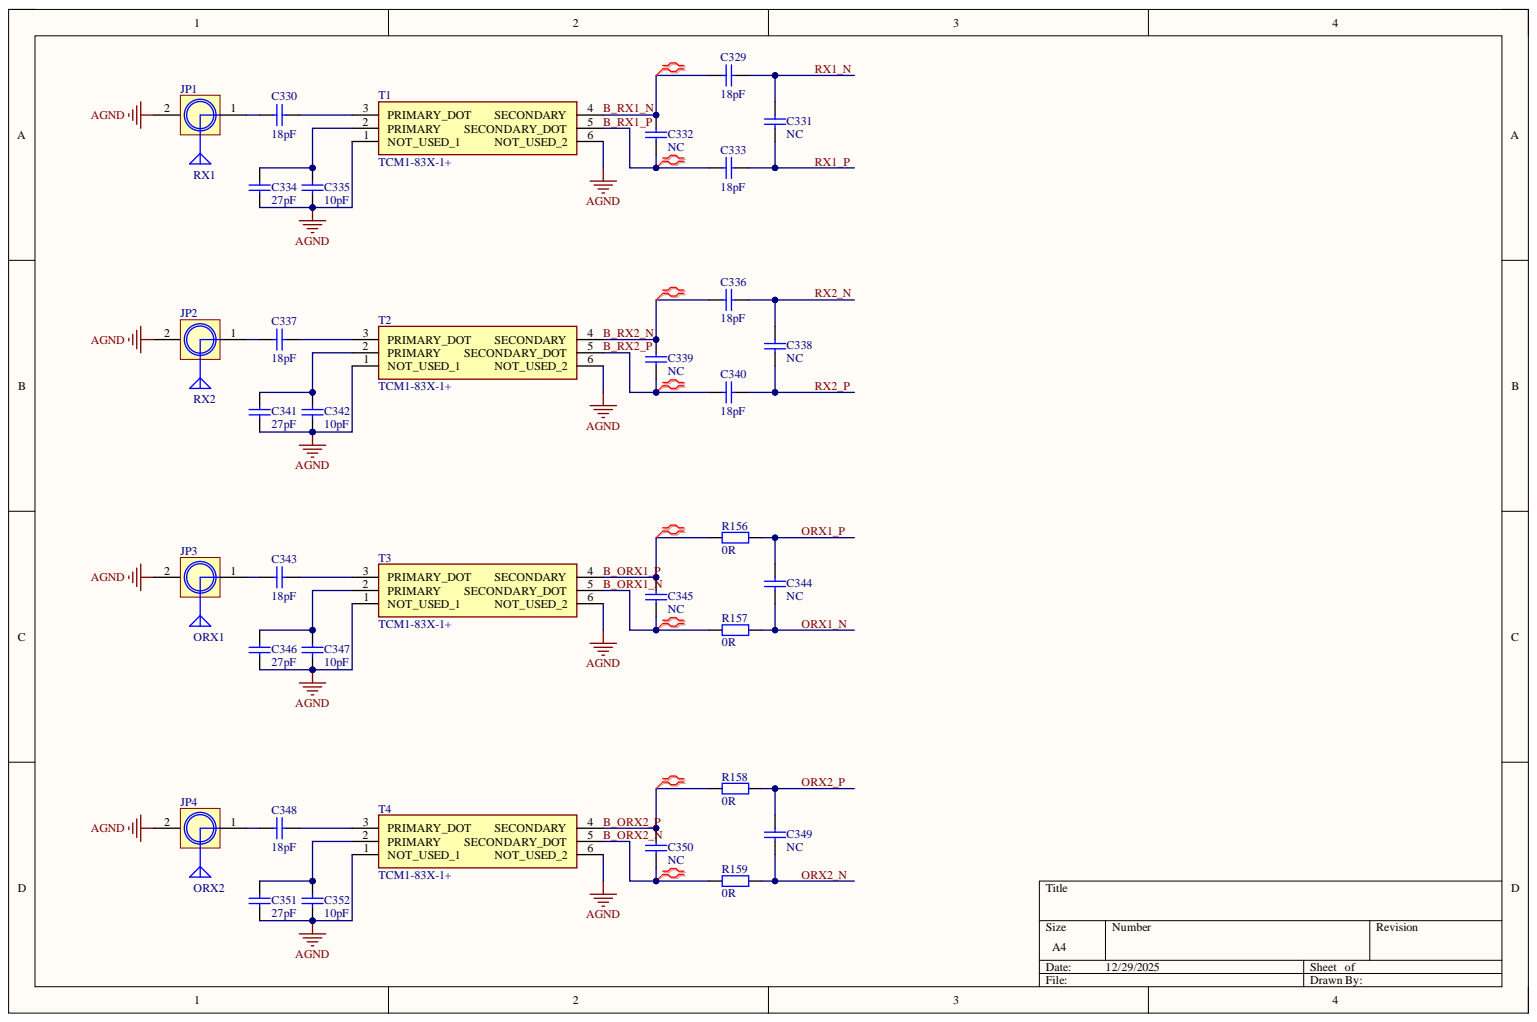
[picture p23: page 16]
Size; umb; Rev; Draw; PRIMA; SECO; TCM1-8; 4ORX; ORX; 3ORX; 9ORX; P4ORX

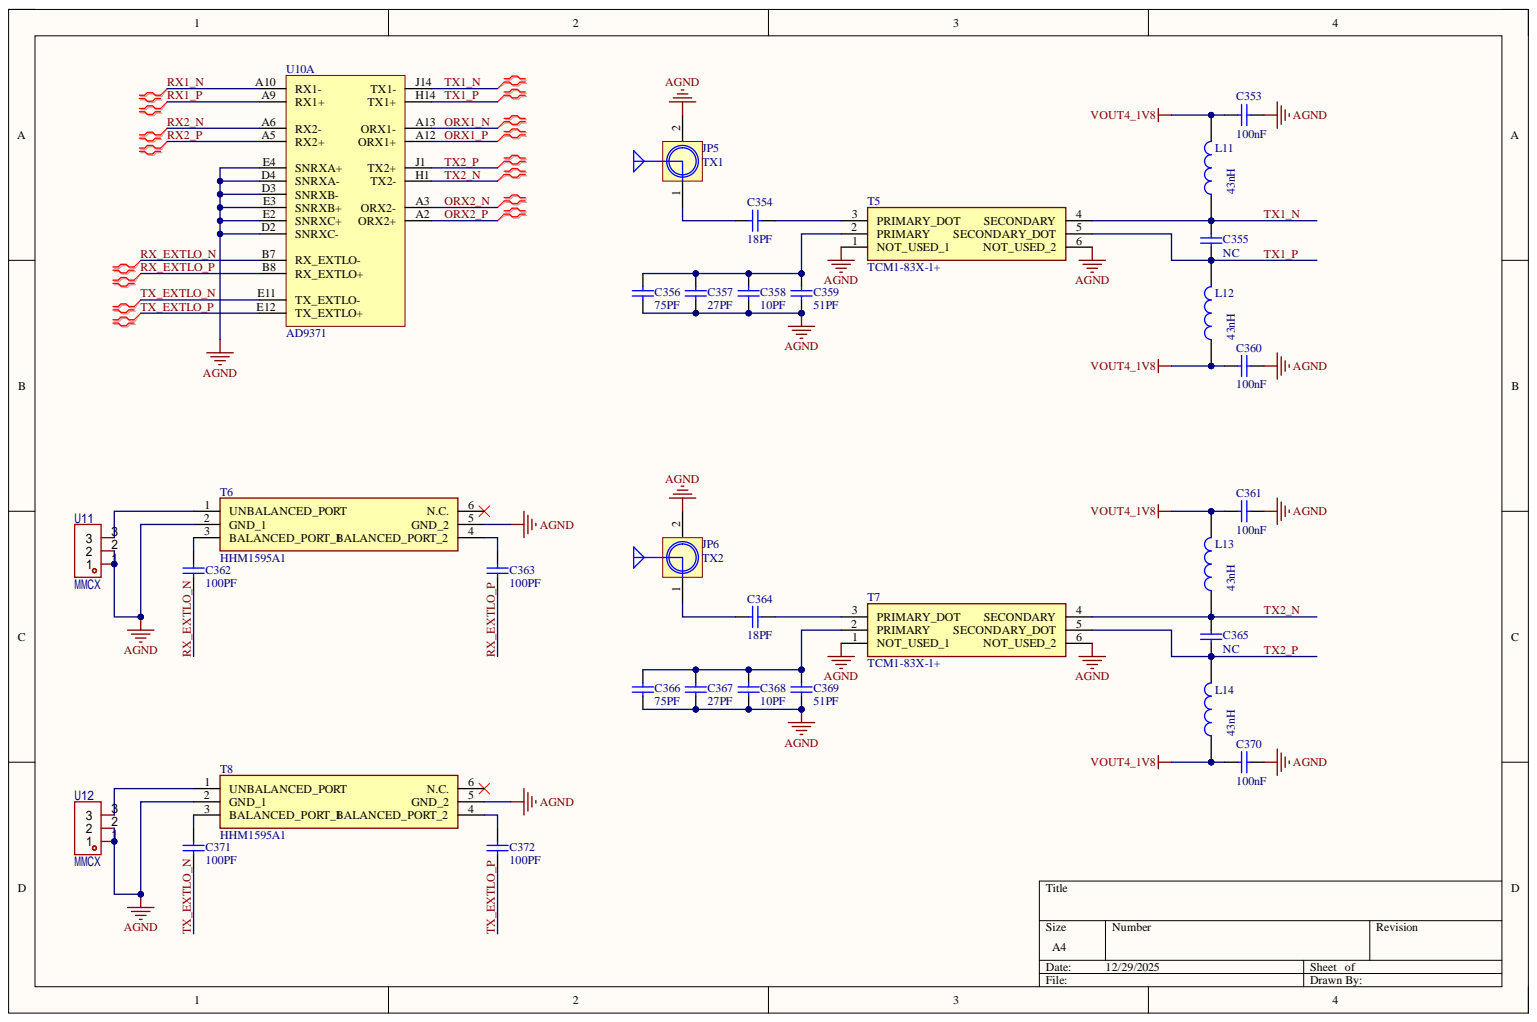
[picture p24: page 17]
Size; umb; Rev; SNRX; SNRXB+; SNRXC+; ORX; PRIMA; SECO; TCM1-8; EXTLO; MMCX; NBA; NCE; 8HHM1; 6HHM1

# REF CLK

# VCXO

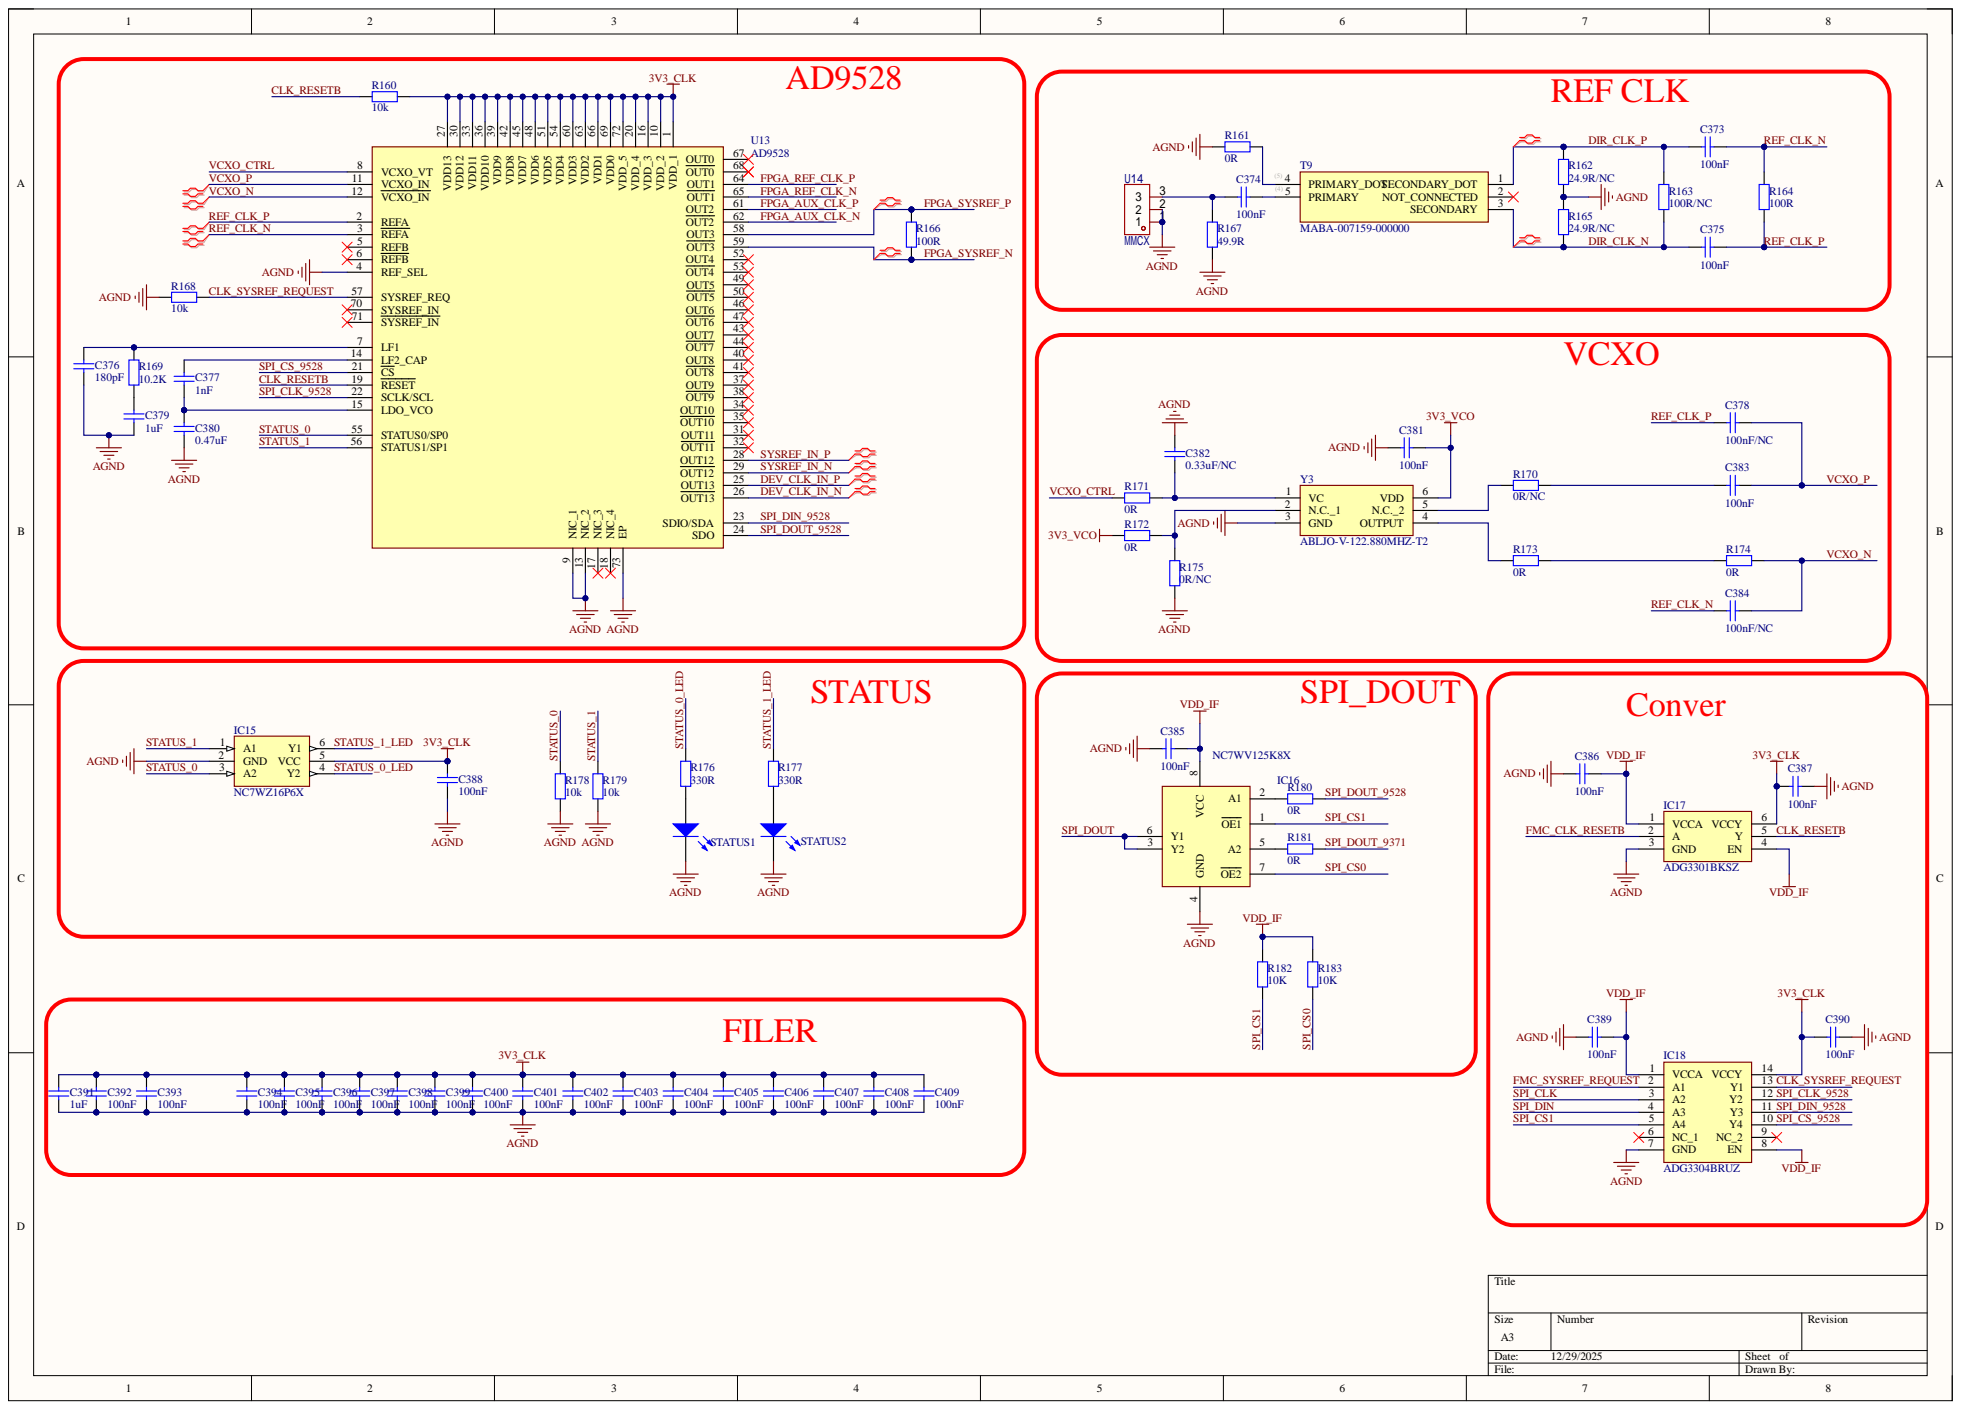
[picture p25: page 18]

GPIO_Interface | SERD

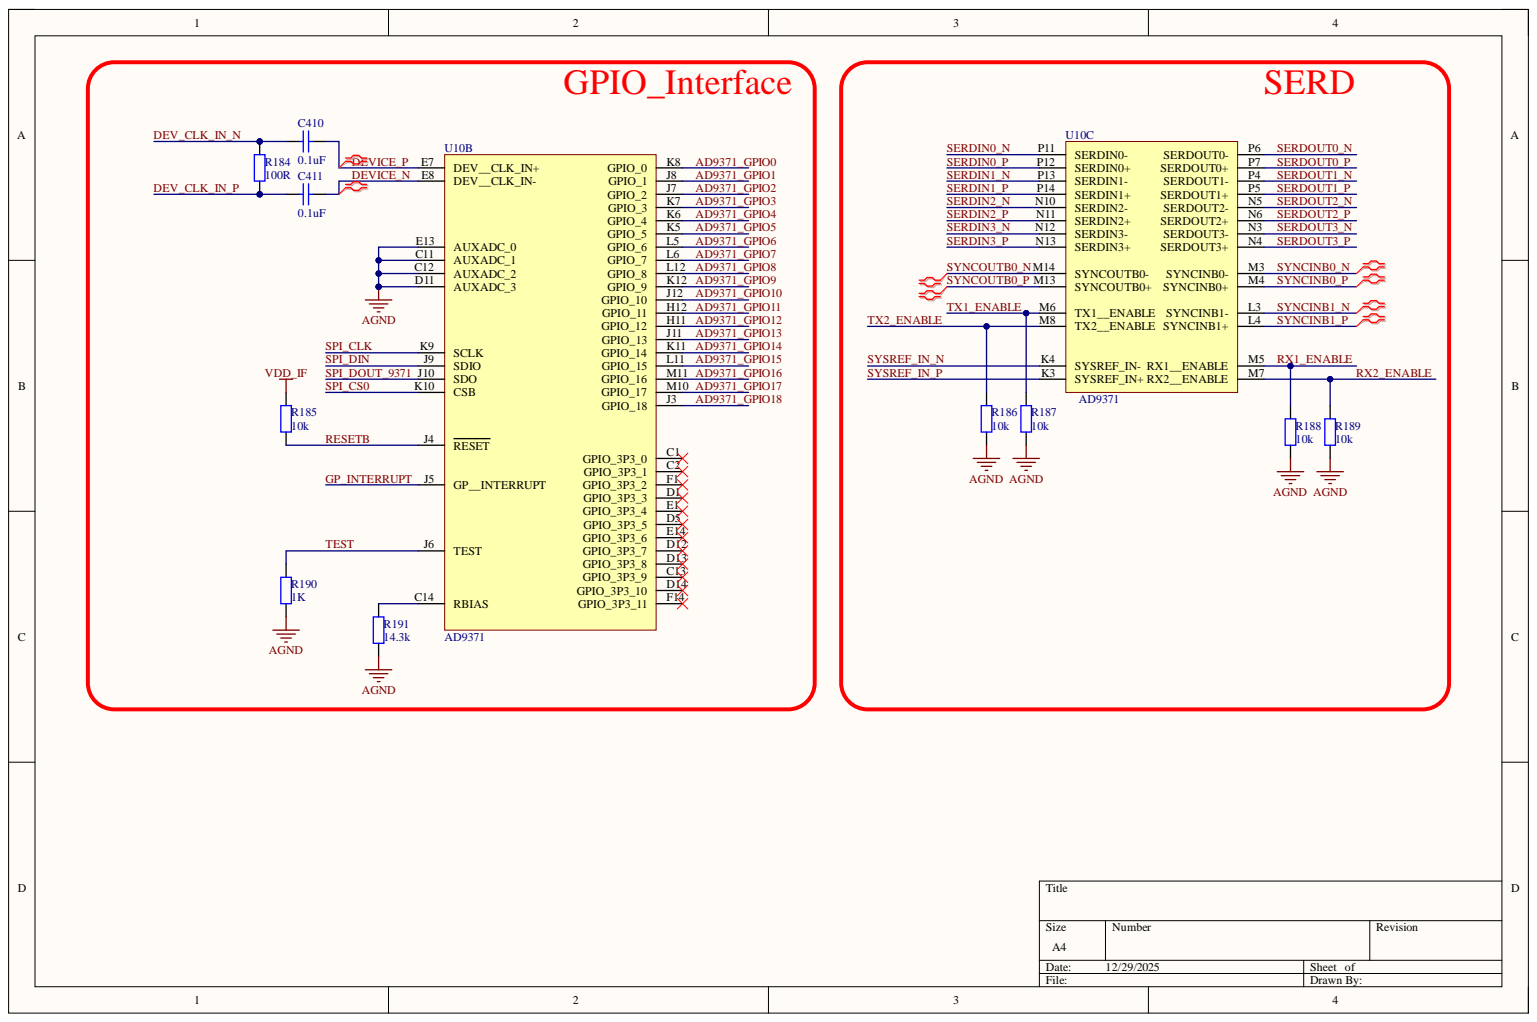
[picture p26: page 19]

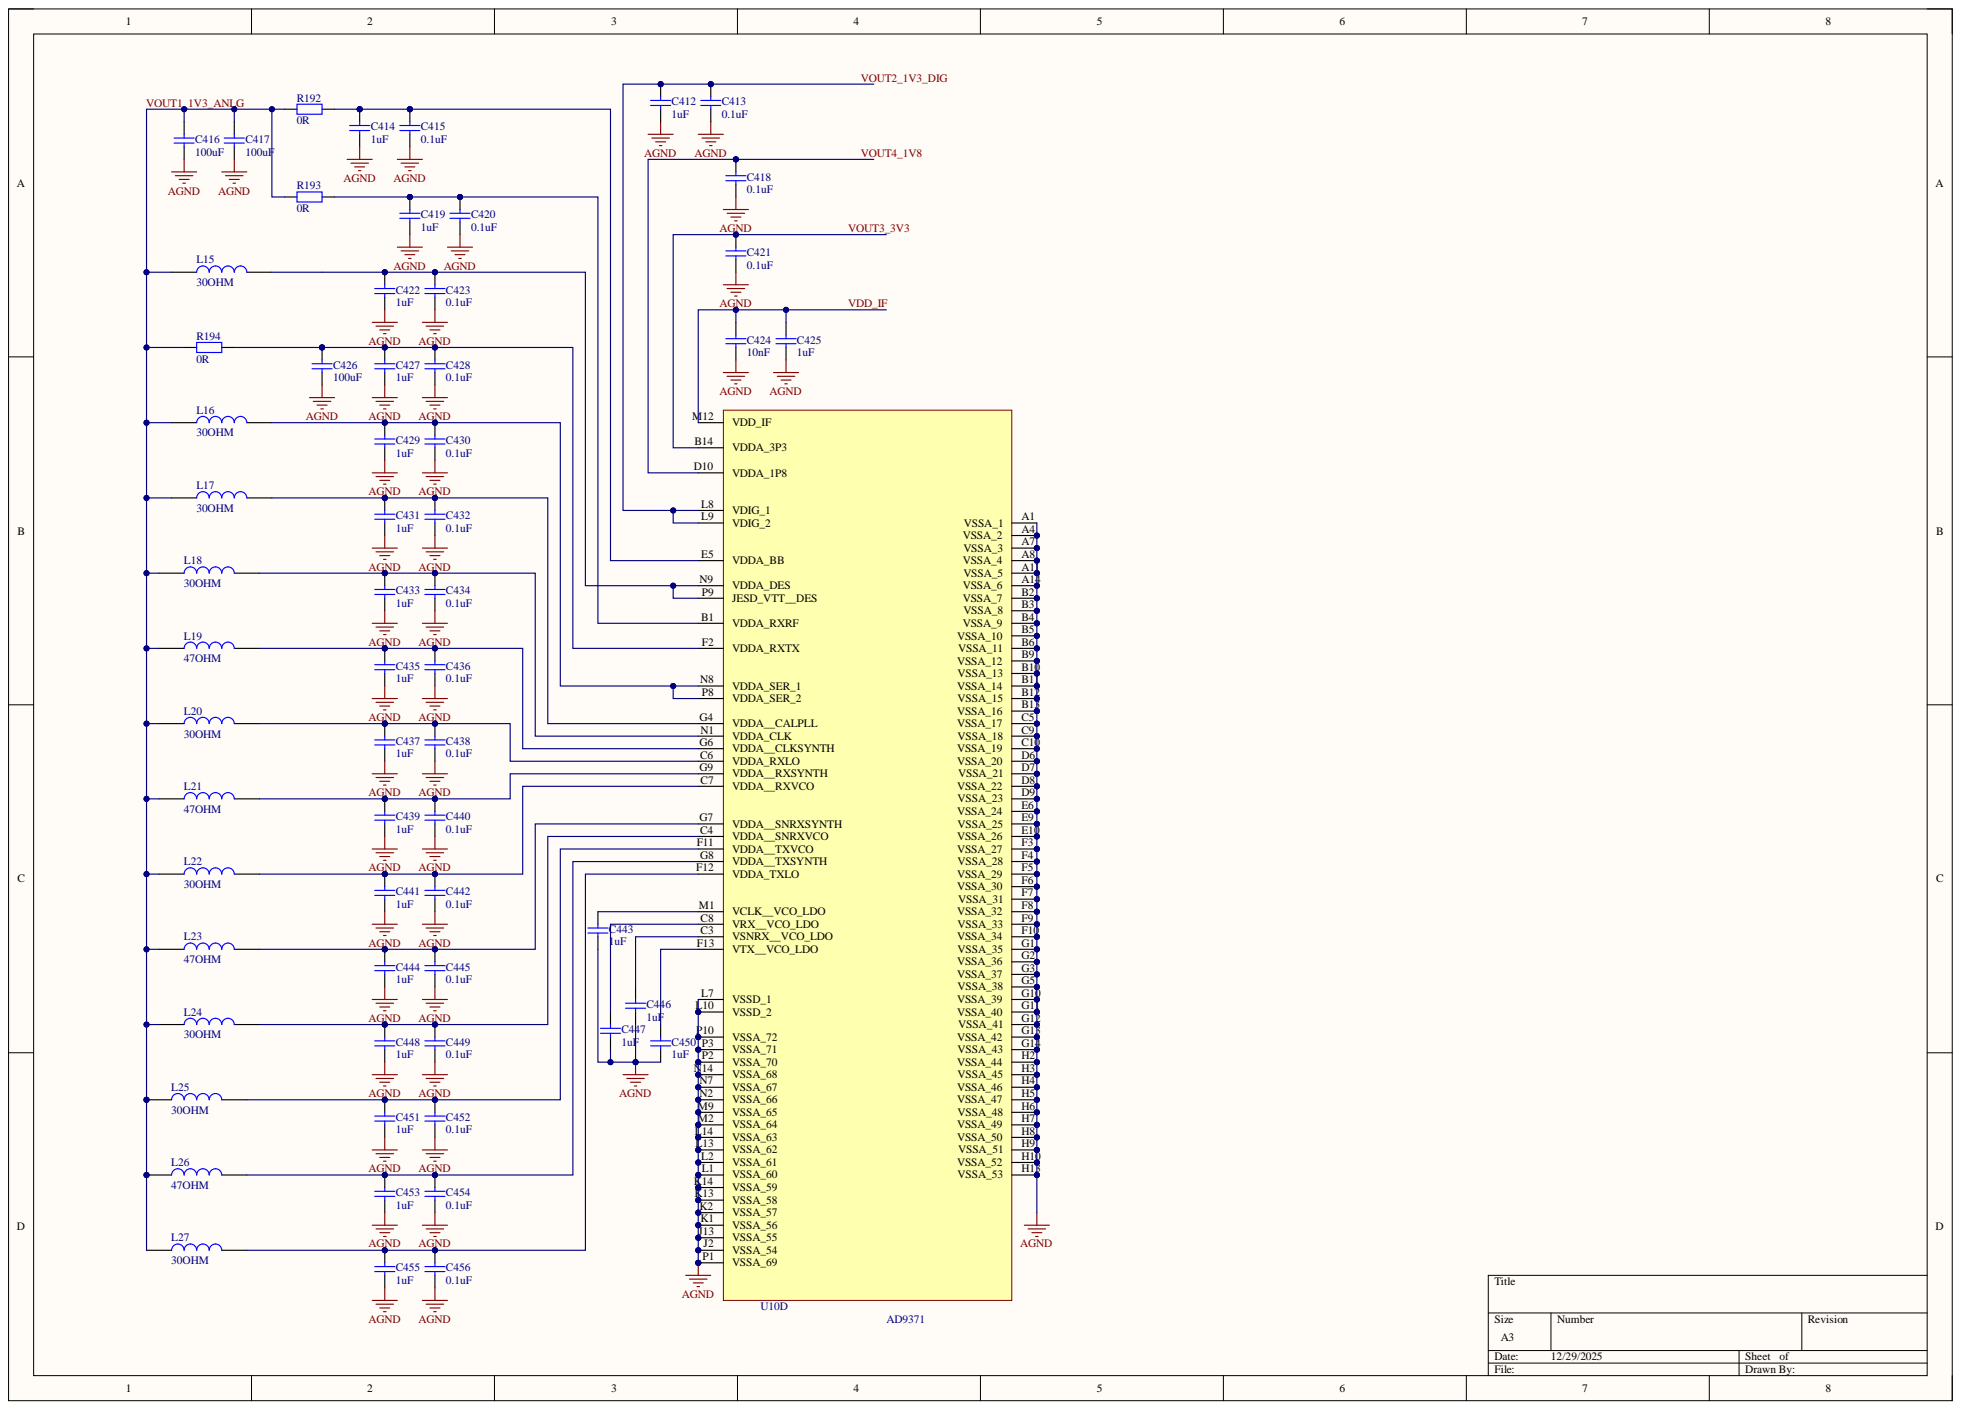
[picture p27: page 20]

ADP5054 | FeedBack | FILTER

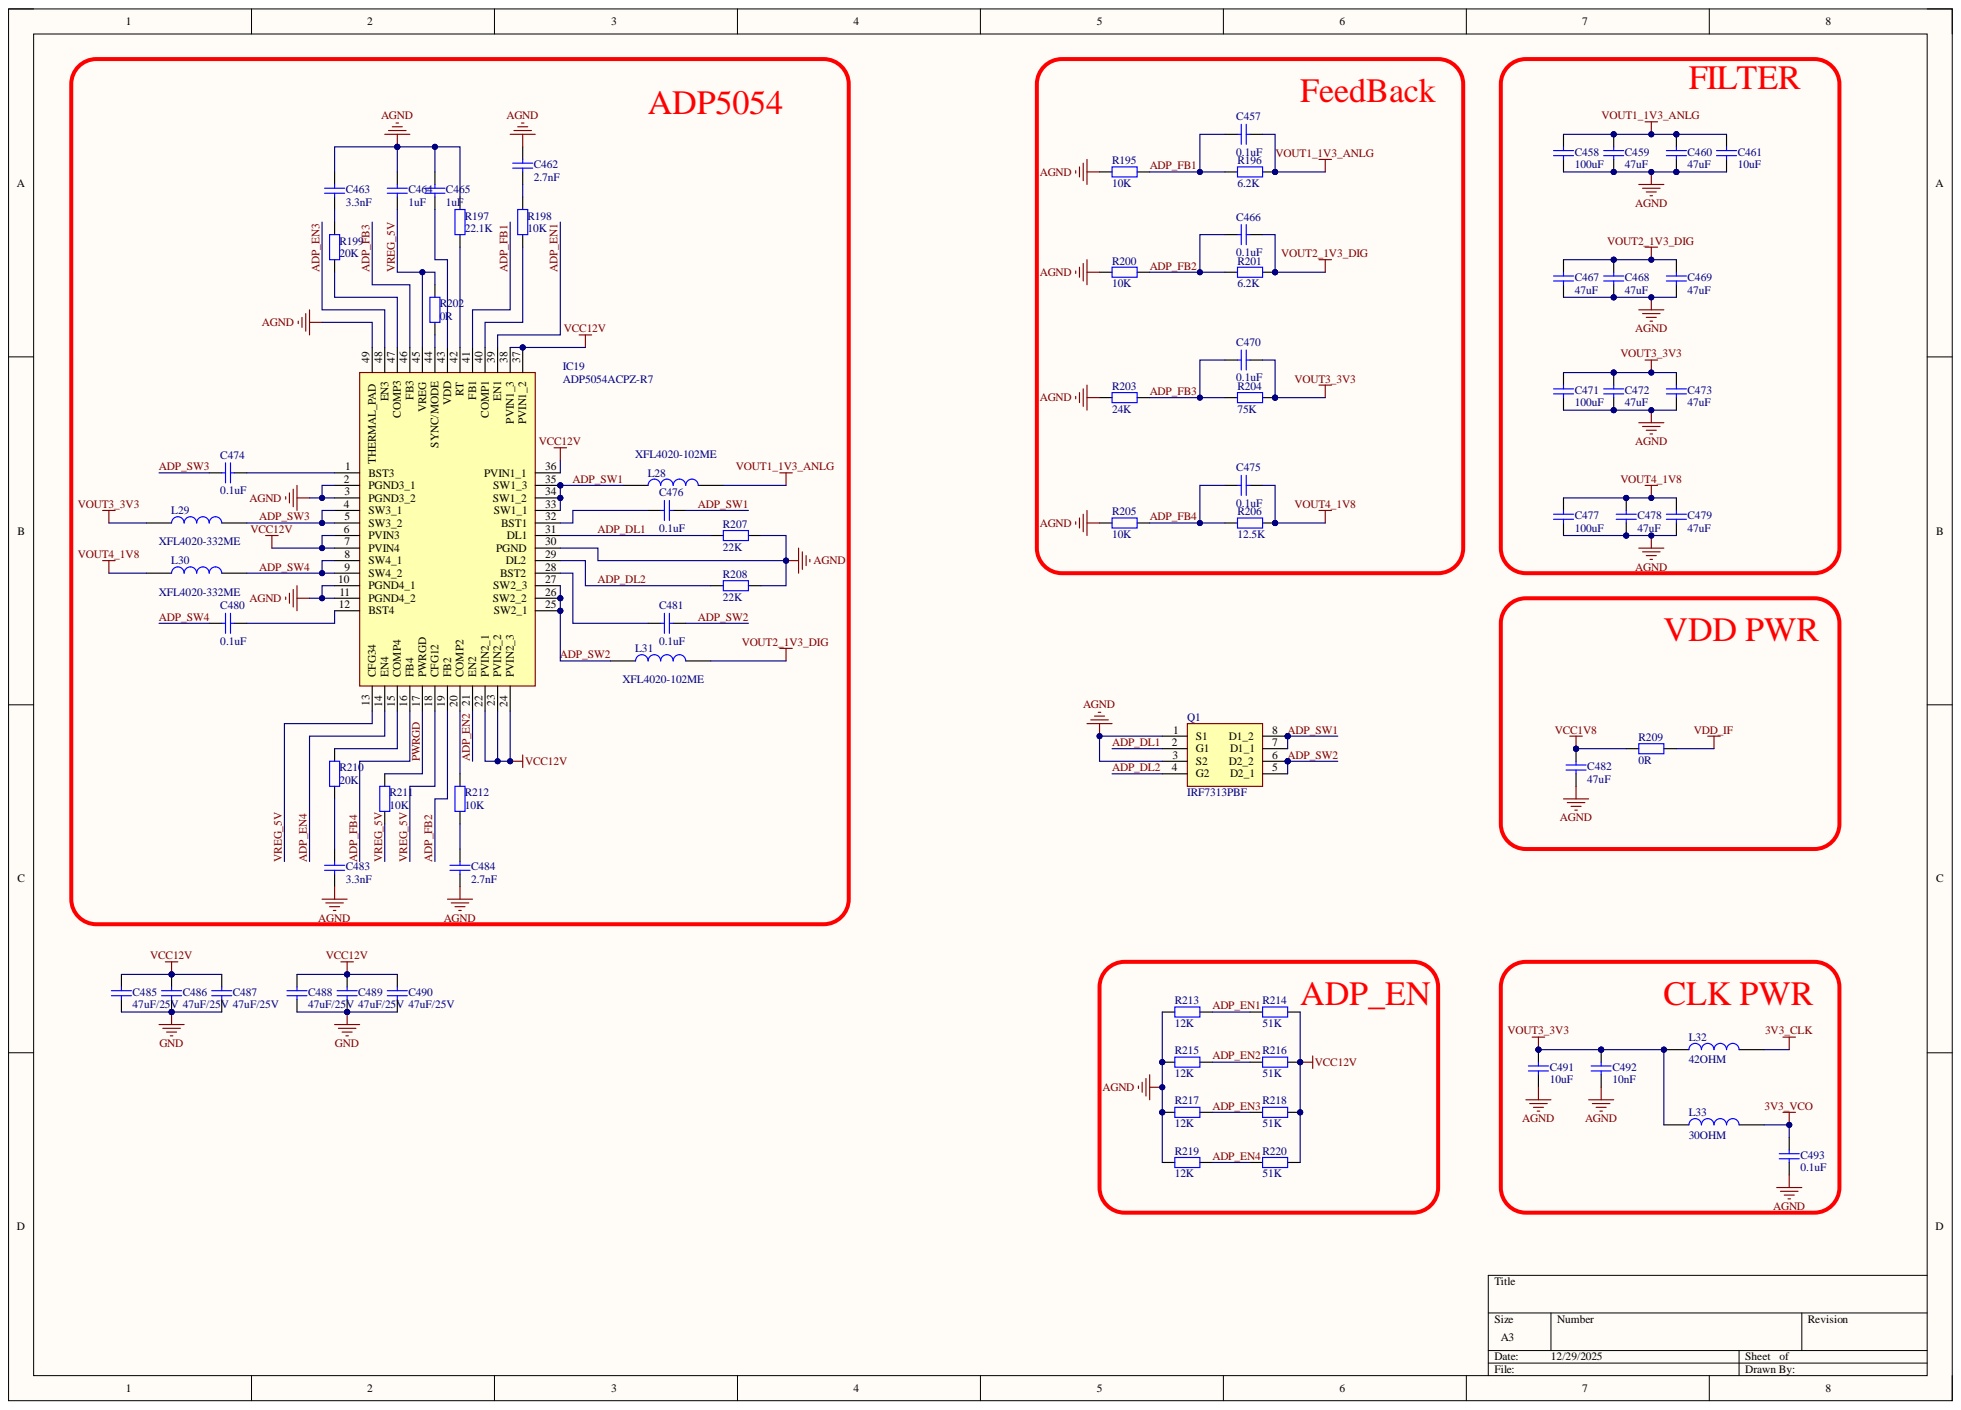
[picture p28: page 21]

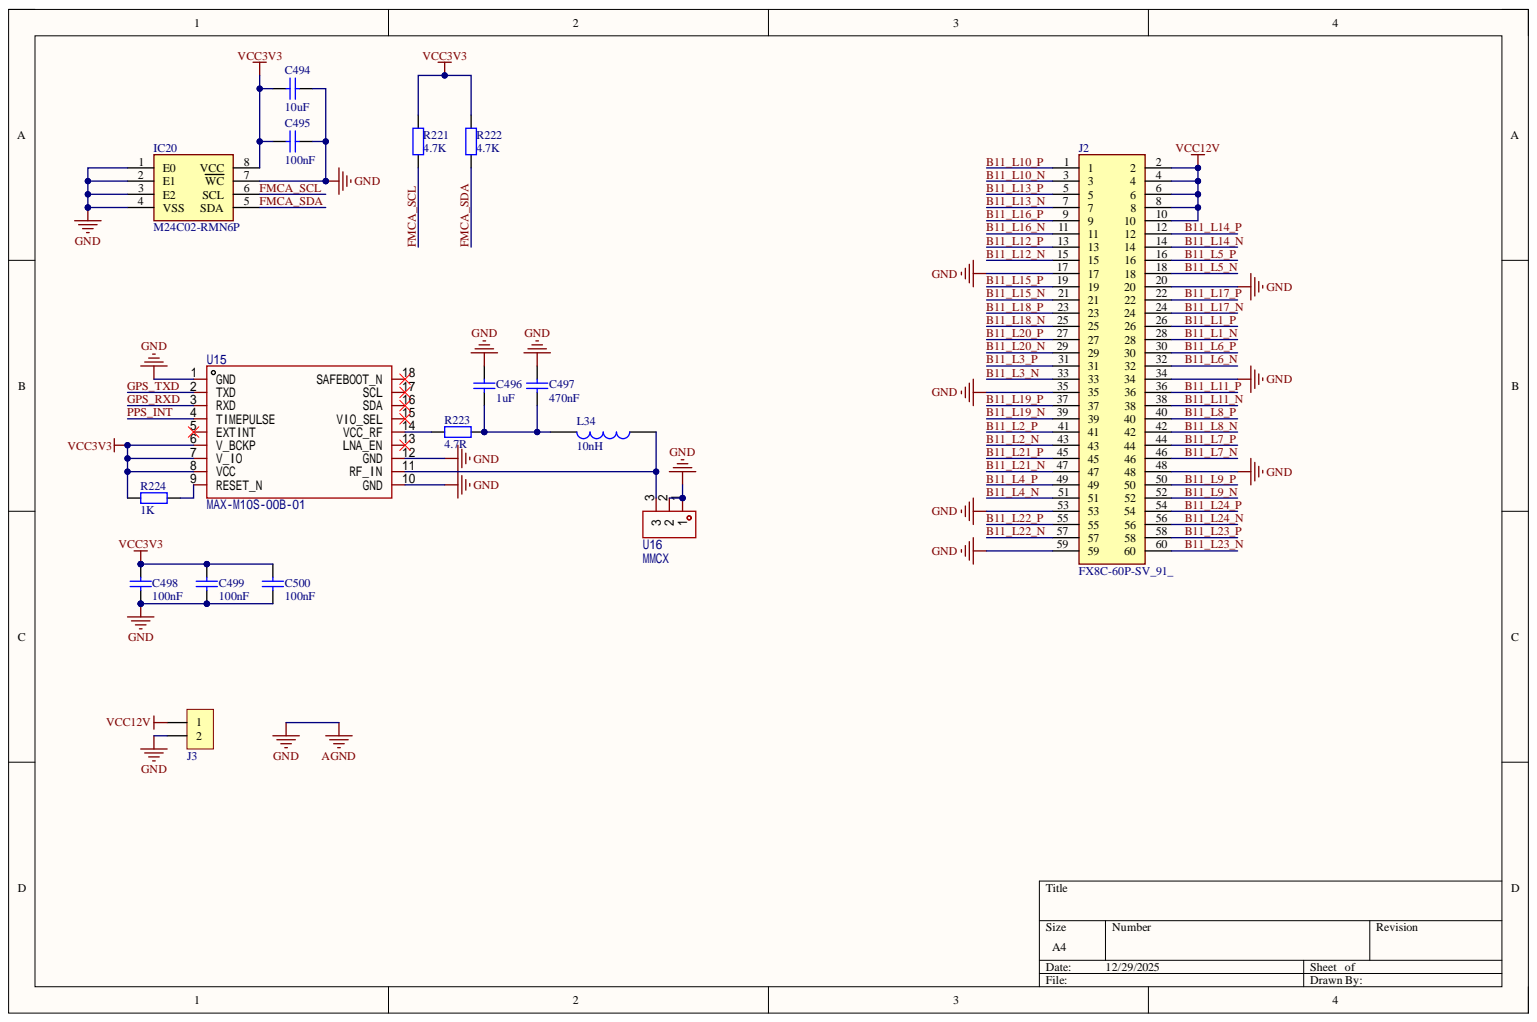
[picture p29: page 22]
Size; umb; Rev; Draw; VSS; VCC; SCL; 2-RMN; FMCA; _SCL; SDA; VCC3; GND TXD RXD TIMEPULSE EXTINT V_BCKP V_IO VCC; RESET_N; GND; 11 GND; 12 LNA_EN; 13 VCC_RF; 14 VIO_SEL; 15 SDA; 16 SCL; 17 SAFEBOOT_N; MAX-M10S-00B-01; GPS_; D GPS_RX; PPS_IN; U16 MMCX; VCC1; VGN
