OpenSourceSDRLab/XC7Z100-ADRV9371/linux/hdl/projects/adrv9371x/zc706/system_constr.xdc

# ad9371
set_property  -dict {PACKAGE_PIN  AD10} [get_ports ref_clk0_p]                                       ; ## D04  FMC_HPC_GBTCLK0_M2C_P (NC)
set_property  -dict {PACKAGE_PIN  AD9 } [get_ports ref_clk0_n]                                       ; ## D05  FMC_HPC_GBTCLK0_M2C_N (NC)
set_property  -dict {PACKAGE_PIN  AF10 } [get_ports ref_clk1_p]                                       ; ## B20  FMC_HPC_GBTCLK1_M2C_P
set_property  -dict {PACKAGE_PIN  AF9 } [get_ports ref_clk1_n]                                       ; ## B21  FMC_HPC_GBTCLK1_M2C_N
set_property  -dict {PACKAGE_PIN  AG8 } [get_ports rx_data_p[0]]                                           ; ## A02  FMC_HPC_DP1_M2C_P
set_property  -dict {PACKAGE_PIN  AG7 } [get_ports rx_data_n[0]]                                           ; ## A03  FMC_HPC_DP1_M2C_N
set_property  -dict {PACKAGE_PIN  AH10 } [get_ports rx_data_p[1]]                                           ; ## A06  FMC_HPC_DP2_M2C_P
set_property  -dict {PACKAGE_PIN  AH9 } [get_ports rx_data_n[1]]                                           ; ## A07  FMC_HPC_DP2_M2C_N
set_property  -dict {PACKAGE_PIN  AE8} [get_ports rx_data_p[2]]                                           ; ## C06  FMC_HPC_DP0_M2C_P
set_property  -dict {PACKAGE_PIN  AE7 } [get_ports rx_data_n[2]]                                           ; ## C07  FMC_HPC_DP0_M2C_N
set_property  -dict {PACKAGE_PIN  AJ8 } [get_ports rx_data_p[3]]                                           ; ## A10  FMC_HPC_DP3_M2C_P
set_property  -dict {PACKAGE_PIN  AJ7 } [get_ports rx_data_n[3]]                                           ; ## A11  FMC_HPC_DP3_M2C_N
set_property  -dict {PACKAGE_PIN  AK10 } [get_ports tx_data_p[0]]                                          ; ## A22  FMC_HPC_DP1_C2M_P (tx_data_p[3])
set_property  -dict {PACKAGE_PIN  AK9 } [get_ports tx_data_n[0]]                                          ; ## A23  FMC_HPC_DP1_C2M_N (tx_data_n[3])
set_property  -dict {PACKAGE_PIN  AK2 } [get_ports tx_data_p[1]]                                          ; ## A26  FMC_HPC_DP2_C2M_P (tx_data_p[0])
set_property  -dict {PACKAGE_PIN  AK1 } [get_ports tx_data_n[1]]                                          ; ## A27  FMC_HPC_DP2_C2M_N (tx_data_n[0])
set_property  -dict {PACKAGE_PIN  AK6} [get_ports  tx_data_p[2]]                                          ; ## C02  FMC_HPC_DP0_C2M_P (tx_data_p[1])
set_property  -dict {PACKAGE_PIN  AK5 } [get_ports tx_data_n[2]]                                          ; ## C03  FMC_HPC_DP0_C2M_N (tx_data_n[1])
set_property  -dict {PACKAGE_PIN  AJ4 } [get_ports tx_data_p[3]]                                          ; ## A30  FMC_HPC_DP3_C2M_P (tx_data_p[2])
set_property  -dict {PACKAGE_PIN  AJ3 } [get_ports tx_data_n[3]]                                          ; ## A31  FMC_HPC_DP3_C2M_N (tx_data_n[2])
set_property  -dict {PACKAGE_PIN  AK13  IOSTANDARD LVDS_25 DIFF_TERM TRUE} [get_ports rx_sync_p]        ; ## G09  FMC_HPC_LA03_P
set_property  -dict {PACKAGE_PIN  AK12  IOSTANDARD LVDS_25 DIFF_TERM TRUE} [get_ports rx_sync_n]        ; ## G10  FMC_HPC_LA03_N
set_property  -dict {PACKAGE_PIN  AJ14   IOSTANDARD LVDS_25 DIFF_TERM TRUE} [get_ports rx_os_sync_p]  ; ## G27  FMC_HPC_LA25_P (Sniffer)
set_property  -dict {PACKAGE_PIN  AJ13   IOSTANDARD LVDS_25 DIFF_TERM TRUE} [get_ports rx_os_sync_n]  ; ## G28  FMC_HPC_LA25_N (Sniffer)
set_property  -dict {PACKAGE_PIN  AJ15  IOSTANDARD LVDS_25 DIFF_TERM TRUE} [get_ports tx_sync_p]      ; ## H07  FMC_HPC_LA02_P
set_property  -dict {PACKAGE_PIN  AK15  IOSTANDARD LVDS_25 DIFF_TERM TRUE} [get_ports tx_sync_n]      ; ## H08  FMC_HPC_LA02_N
set_property  -dict {PACKAGE_PIN  AF15   IOSTANDARD LVDS_25 DIFF_TERM TRUE} [get_ports sysref_p]       ; ## G36  FMC_HPC_LA33_P
set_property  -dict {PACKAGE_PIN  AG15   IOSTANDARD LVDS_25 DIFF_TERM TRUE} [get_ports sysref_n]       ; ## G37  FMC_HPC_LA33_N

set_property  -dict {PACKAGE_PIN  AG12  IOSTANDARD LVCMOS25} [get_ports spi_csn_ad9528]               ; ## D15  FMC_HPC_LA09_N
set_property  -dict {PACKAGE_PIN  AA14  IOSTANDARD LVCMOS25} [get_ports spi_csn_ad9371]               ; ## D14  FMC_HPC_LA09_P
set_property  -dict {PACKAGE_PIN  AB12  IOSTANDARD LVCMOS25} [get_ports spi_clk]                      ; ## H13  FMC_HPC_LA07_P
set_property  -dict {PACKAGE_PIN  AH12  IOSTANDARD LVCMOS25} [get_ports spi_mosi]                     ; ## H14  FMC_HPC_LA07_N
set_property  -dict {PACKAGE_PIN  AF13  IOSTANDARD LVCMOS25} [get_ports spi_miso]                     ; ## G12  FMC_HPC_LA08_P

set_property  -dict {PACKAGE_PIN  AE12   IOSTANDARD LVCMOS25} [get_ports ad9528_reset_b]               ; ## D26  FMC_HPC_LA26_P
set_property  -dict {PACKAGE_PIN  AC12   IOSTANDARD LVCMOS25} [get_ports ad9528_sysref_req]            ; ## D27  FMC_HPC_LA26_N
set_property  -dict {PACKAGE_PIN  AB15  IOSTANDARD LVCMOS25} [get_ports ad9371_tx1_enable]            ; ## D17  FMC_HPC_LA13_P
set_property  -dict {PACKAGE_PIN  AH13  IOSTANDARD LVCMOS25} [get_ports ad9371_tx2_enable]            ; ## C18  FMC_HPC_LA14_P
set_property  -dict {PACKAGE_PIN  AE15  IOSTANDARD LVCMOS25} [get_ports ad9371_rx1_enable]            ; ## D18  FMC_HPC_LA13_N
set_property  -dict {PACKAGE_PIN  AD14  IOSTANDARD LVCMOS25} [get_ports ad9371_rx2_enable]            ; ## C19  FMC_HPC_LA14_N
set_property  -dict {PACKAGE_PIN  AE16  IOSTANDARD LVCMOS25} [get_ports ad9371_test]                  ; ## D11  FMC_HPC_LA05_P
set_property  -dict {PACKAGE_PIN  AC16  IOSTANDARD LVCMOS25} [get_ports ad9371_reset_b]               ; ## H10  FMC_HPC_LA04_P
set_property  -dict {PACKAGE_PIN  AE18  IOSTANDARD LVCMOS25} [get_ports ad9371_gpint]                 ; ## H11  FMC_HPC_LA04_N

set_property  -dict {PACKAGE_PIN  AF18   IOSTANDARD LVCMOS25} [get_ports ad9371_gpio_00]               ; ## H19  FMC_HPC_LA15_P
set_property  -dict {PACKAGE_PIN  AH18   IOSTANDARD LVCMOS25} [get_ports ad9371_gpio_01]               ; ## H20  FMC_HPC_LA15_N
set_property  -dict {PACKAGE_PIN  AF17  IOSTANDARD LVCMOS25} [get_ports ad9371_gpio_02]               ; ## G18  FMC_HPC_LA16_P
set_property  -dict {PACKAGE_PIN  AH16  IOSTANDARD LVCMOS25} [get_ports ad9371_gpio_03]               ; ## G19  FMC_HPC_LA16_N
set_property  -dict {PACKAGE_PIN  AB17   IOSTANDARD LVCMOS25} [get_ports ad9371_gpio_04]               ; ## H25  FMC_HPC_LA21_P
set_property  -dict {PACKAGE_PIN  AJ16   IOSTANDARD LVCMOS25} [get_ports ad9371_gpio_05]               ; ## H26  FMC_HPC_LA21_N
set_property  -dict {PACKAGE_PIN  AK16   IOSTANDARD LVCMOS25} [get_ports ad9371_gpio_06]               ; ## C22  FMC_HPC_LA18_CC_P
set_property  -dict {PACKAGE_PIN  AC17   IOSTANDARD LVCMOS25} [get_ports ad9371_gpio_07]               ; ## C23  FMC_HPC_LA18_CC_N
set_property  -dict {PACKAGE_PIN  AC14   IOSTANDARD LVCMOS25} [get_ports ad9371_gpio_15]               ; ## G24  FMC_HPC_LA22_P     (LVDS Pairs?)
set_property  -dict {PACKAGE_PIN  AC13   IOSTANDARD LVCMOS25} [get_ports ad9371_gpio_08]               ; ## G25  FMC_HPC_LA22_N     (LVDS Pairs?)
set_property  -dict {PACKAGE_PIN  AA15   IOSTANDARD LVCMOS25} [get_ports ad9371_gpio_09]               ; ## H22  FMC_HPC_LA19_P     (LVDS Pairs?)
set_property  -dict {PACKAGE_PIN  AD16   IOSTANDARD LVCMOS25} [get_ports ad9371_gpio_10]               ; ## H23  FMC_HPC_LA19_N     (LVDS Pairs?)
set_property  -dict {PACKAGE_PIN  AD15   IOSTANDARD LVCMOS25} [get_ports ad9371_gpio_11]               ; ## G21  FMC_HPC_LA20_P     (LVDS Pairs?)
set_property  -dict {PACKAGE_PIN  AJ18   IOSTANDARD LVCMOS25} [get_ports ad9371_gpio_12]               ; ## G22  FMC_HPC_LA20_N     (LVDS Pairs?)
set_property  -dict {PACKAGE_PIN  AB14   IOSTANDARD LVCMOS25} [get_ports ad9371_gpio_14]               ; ## G30  FMC_HPC_LA29_P     (LVDS Pairs?)
set_property  -dict {PACKAGE_PIN  AE17   IOSTANDARD LVCMOS25} [get_ports ad9371_gpio_13]               ; ## G31  FMC_HPC_LA29_N     (LVDS Pairs?)
set_property  -dict {PACKAGE_PIN  AE13  IOSTANDARD LVCMOS25} [get_ports ad9371_gpio_17]               ; ## G15  FMC_HPC_LA12_P     (LVDS Pairs?)
set_property  -dict {PACKAGE_PIN  AD13  IOSTANDARD LVCMOS25} [get_ports ad9371_gpio_16]               ; ## G16  FMC_HPC_LA12_N     (LVDS Pairs?)
set_property  -dict {PACKAGE_PIN  AH17  IOSTANDARD LVCMOS25} [get_ports ad9371_gpio_18]               ; ## D12  FMC_HPC_LA05_N

# clocks

create_clock -name tx_ref_clk     -period  8.00 [get_ports ref_clk0_p]
create_clock -name rx_ref_clk     -period  8.00 [get_ports ref_clk1_p]
create_clock -name tx_div_clk     -period  8.00 [get_pins i_system_wrapper/system_i/util_ad9371_xcvr/inst/i_xch_0/i_gtxe2_channel/TXOUTCLK]
create_clock -name rx_div_clk     -period  8.00 [get_pins i_system_wrapper/system_i/util_ad9371_xcvr/inst/i_xch_0/i_gtxe2_channel/RXOUTCLK]
create_clock -name rx_os_div_clk  -period  8.00 [get_pins i_system_wrapper/system_i/util_ad9371_xcvr/inst/i_xch_2/i_gtxe2_channel/RXOUTCLK]
