OpenSourceSDRLab/XC7Z100-ADRV9371/baremetal/ADRV9371_JESD204B_PS/FMC_AD9371_PS/mykonos/mykonos_macros.h

/**
 * \file mykonos_macros.h
 * \brief Contains address and miscellaneous macro definitions for Mykonos API
 *
 * Mykonos API version: 1.5.1.3565
 */

/**
* \page Disclaimer Legal Disclaimer
* Copyright 2015-2017 Analog Devices Inc.
* Released under the AD9371 API license, for more information see the "LICENSE.txt" file in this zip file.
*
*/

#ifndef CLEMENTE_TDD_MACROS_H
#define CLEMENTE_TDD_MACROS_H

#ifdef __cplusplus
extern "C" {
#endif

#define MYKONOS_ADDR_CONFIGURATION_CONTROL_0                0x000
#define MYKONOS_ADDR_SPI_CONFIGURATION_CONTROL_1            0x001
#define MYKONOS_ADDR_PRODUCT_ID                             0x004
#define MYKONOS_GPIO_DRV_CTL_0                              0x020
#define MYKONOS_GPIO_DRV_CTL_1                              0x021
#define MYKONOS_GPIO_SLEW_CTL_0                             0x022
#define MYKONOS_GPIO_SLEW_CTL_1                             0x023
#define MYKONOS_GPIO_SLEW_CTL_2                             0x024
#define MYKONOS_GPIO_SLEW_CTL_3                             0x025

#define MYKONOS_ADDR_DIGITAL_IO_CONTROL                     0x028

#define MYKONOS_ADDR_SYSREF_PAD_CONFIG                      0x040
#define MYKONOS_ADDR_TX1_SYNC_PAD_CONFIG                    0x041
#define MYKONOS_ADDR_TX2_SYNC_PAD_CONFIG                    0x042
#define MYKONOS_ADDR_RX1_SYNC_CONFIG                        0x043
#define MYKONOS_ADDR_RX2_SYNC_CONFIG                        0x044

/* Mykonos Framer Registers */
#define MYKONOS_ADDR_FRAMER_RESET                           0x059
#define MYKONOS_ADDR_FRAMER_CLK_EN                          0x05A
#define MYKONOS_ADDR_FRAMER_ADDR                            0x05B
#define MYKONOS_ADDR_FRAMER_DATA                            0x05C
#define MYKONOS_ADDR_FRAMER_WRITE_EN                        0x05D
#define MYKONOS_ADDR_FRAMER_SYSREF_FIFO_EN                  0x05E
#define MYKONOS_ADDR_FRAMER_CONFIG_F                        0x05F
#define MYKONOS_ADDR_FRAMER_LANE_CTL                        0x060
#define MYKONOS_ADDR_FRAMER_ADC_XBAR_SEL                    0x061
#define MYKONOS_ADDR_FRAMER_LANE_XBAR_SEL                   0x062
#define MYKONOS_ADDR_FRAMER_CONFIG_LOOPBACK_XBAR_REV        0x063
#define MYKONOS_ADDR_FRAMER_SYNCN_FILT                      0x064
#define MYKONOS_ADDR_FRAMER_LMFC_F_OFFSET                   0x065
#define MYKONOS_ADDR_FRAMER_LMFC_K_OFFSET                   0x066
#define MYKONOS_ADDR_FRAMER_TEST_CNTR_CTL                   0x067
#define MYKONOS_ADDR_FRAMER_STATUS_STRB                     0x068
#define MYKONOS_ADDR_FRAMER_STATUS                          0x069
#define MYKONOS_ADDR_FRAMER_SYSREF_TO_LMFC_CNTR_STAT        0x06A
#define MYKONOS_ADDR_FRAMER_SYSREF_TO_LMFC_ERR_MARGIN       0x06B
#define MYKONOS_ADDR_FRAMER_LANE_FIFO_STRB                  0x06C
#define MYKONOS_ADDR_FRAMER_LANE0_FIFO_RDWR_ADDR            0x06D
#define MYKONOS_ADDR_FRAMER_LANE1_FIFO_RDWR_ADDR            0x06E
#define MYKONOS_ADDR_FRAMER_LANE2_FIFO_RDWR_ADDR            0x06F
#define MYKONOS_ADDR_FRAMER_LANE3_FIFO_RDWR_ADDR            0x070
#define MYKONOS_ADDR_FRAMER_PRBS10_CTL                      0x071
#define MYKONOS_ADDR_FRAMER_PRBS20_CTL                      0x072
#define MYKONOS_ADDR_FRAMER_PATTERN_GEN_EN                  0x073
#define MYKONOS_ADDR_FRAMER_PATTERN_GEN_7_TO_0              0x074
#define MYKONOS_ADDR_FRAMER_PATTERN_GEN_15_TO_8             0x075
#define MYKONOS_ADDR_FRAMER_PATTERN_GEN_19_TO_16            0x076
#define MYKONOS_ADDR_FRAMER_CONFIG_JTX_GEN                  0x077
#define MYKONOS_ADDR_FRAMER_LANE_DATA_CTL                   0x078
#define MYKONOS_ADDR_FRAMER_DATA_SAMPLE_CTL                 0x079

/* Mykonos Deframer Sub Address Map */
#define MYKONOS_SUBADDR_DEFRAMER_LANE0_ILAS_RECVD           0x00
#define MYKONOS_SUBADDR_DEFRAMER_LANE0_ILAS_CFG             0x50
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
