OpenSourceSDRLab/XC7Z100-ADRV9371/(notices)

Notices in the files:
linux/hdl/projects/adrv9371x/zc706/system_top.v:
of this file, are permitted under one of the following two license terms: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
